ShubhaVijayaraj/EPICS-INDIA-Bullock-Driven-Tractor-Delivery/images/IMG_1473.png

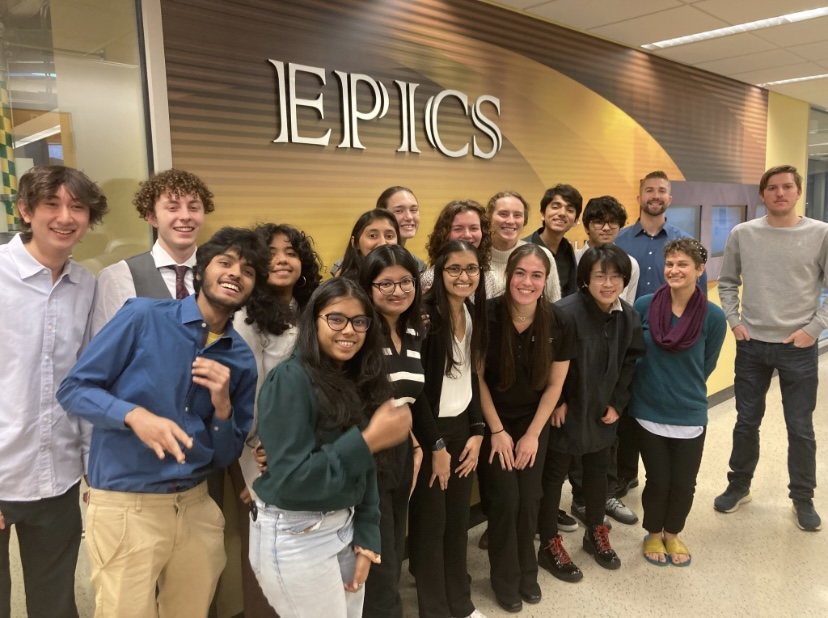
images/IMG_1473.png
