ShubhaVijayaraj/EPICS-INDIA-Bullock-Driven-Tractor-Delivery/Deliverables/Drawings/Frame/Watermarked Frame Drawings.pdf

# Frame Drawings

APPROVED
CHECKED 4/28/2025

SIZE
B

DRAWN Shubha Vijayaraj4/28/2025SCALE

CODE

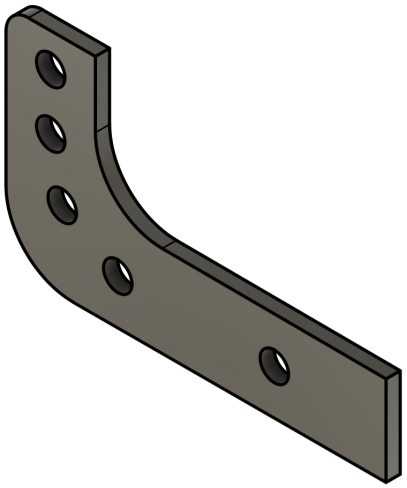
[picture p2: figure]

WEIGHT

DWG NO
1

SHEET

REV

85
60

R10

35

40

20

19.97

25.14

50

120

R30

170

90.33°

Ø12.7

20
40

100

1:2

6.35

1/1

PROJECT

# Bullock Driven Tractor

TITLE

# Hitching Attachment

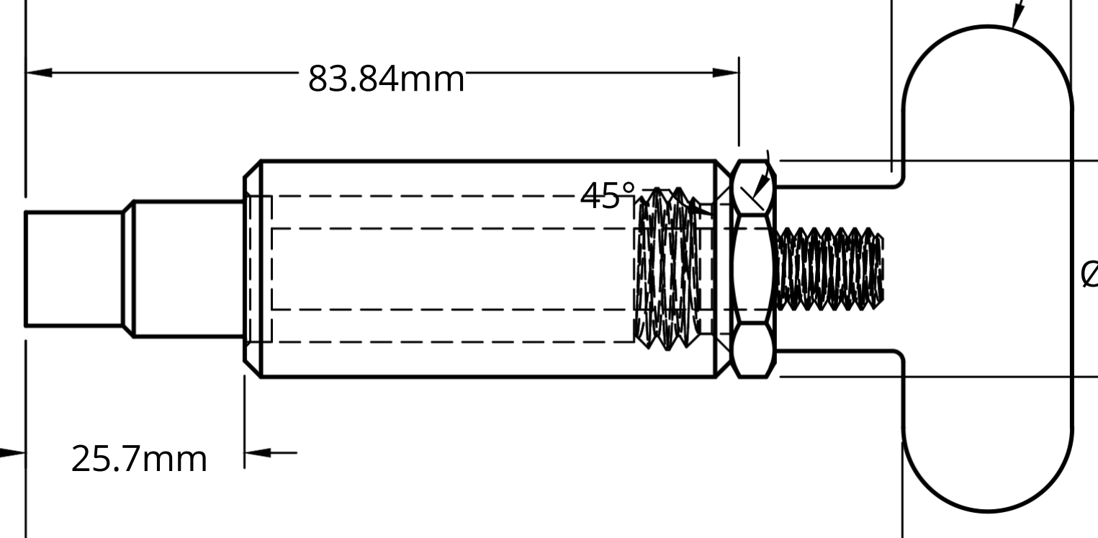
[picture p3: figure]

APPROVED
CHECKED

SIZE

CODE

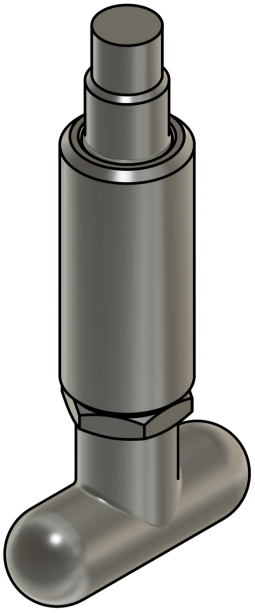
[picture p4: figure]

DWG NO

REV

112.95mm

Ø19.81mm

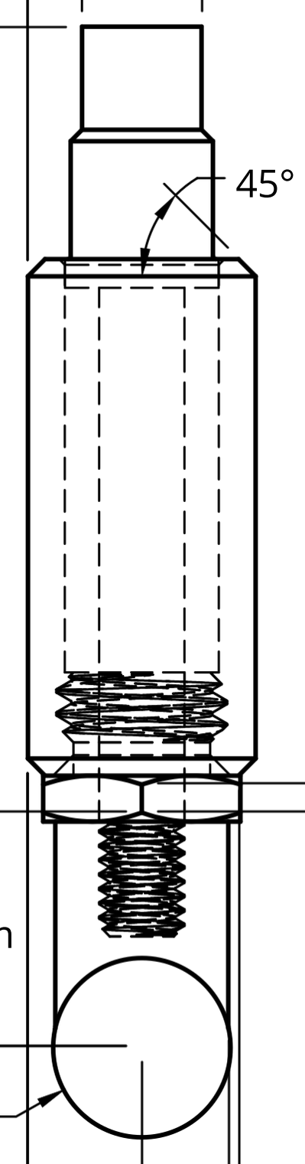
[picture p5: figure]

26mm

12.7mm

22.35mm

23.5mm

19.37mm

6.03mm

3.12mm

103.05mm

122.86mm

101.78mm
R9.91mm

Ø25.4mm

1:1 | 1/1

PROJECT

# BDT

TITLE

# 90222A802_Steel Weld-Mount Retrac

A

P

P

R

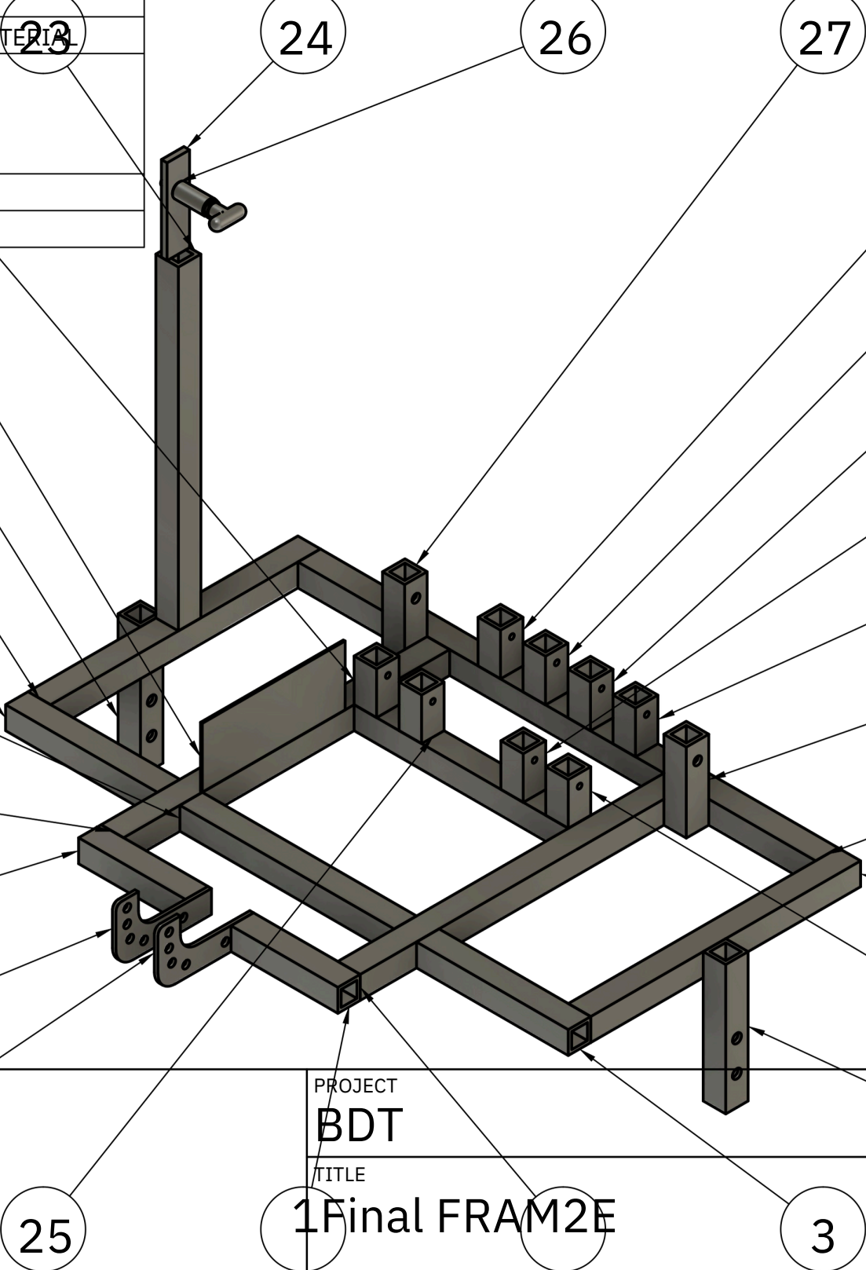
[picture p6: figure]

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
1234567891011121314151617181920212223

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
11111

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
21111
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
2728

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
3612111816

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
# Fin

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
0892854717

APPROVED
CHECKED

SIZE

CODE

DWG NO

REV

40mm

20mm

10mm

50.8mm

150.6mm

Ø15.88 10

1:1 | 1/1

PROJECT

# BDT

TITLE

# Locking Mechniam Vert Bar Arm

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
Dept. | Technical reference

Rev.

DWG No.

Approved by

Document status

Sheet

254mm

Created by
Shubha Vijayaraj4/28/2025

Document type

3.18mm

Date of issue
4/27/2025 1/1

Title

## Foot Protector

1

0

6.2

m

m
