ShubhaVijayaraj/EPICS-INDIA-Bullock-Driven-Tractor-Delivery/images/Screenshot 2025-06-06 010942.png

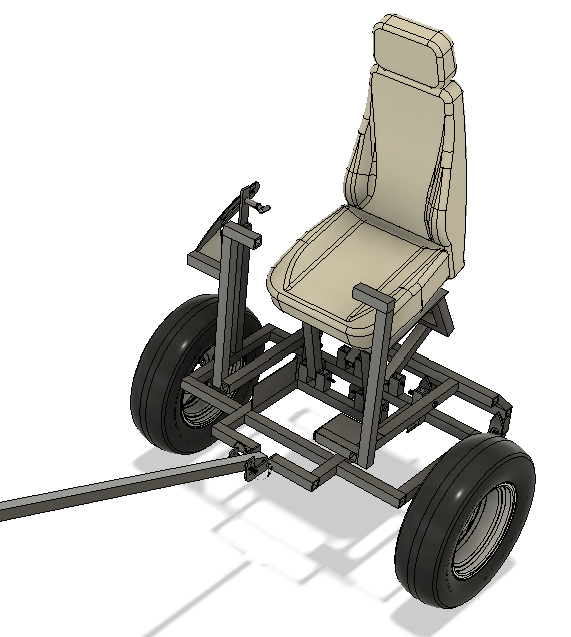
images/Screenshot 2025-06-06 010942.png
