ShubhaVijayaraj/EPICS-INDIA-Bullock-Driven-Tractor-Delivery/Deliverables/Manufacturing Document and B.O.M..xlsx

Sheet: Manufacturing Processes
Component | Subcomponent | Part Name | Part Visual | Process/Operation | Specification/Tolerance
Lifting Mechanism | Locking Mechanism | Arced Bar |  | Waterjet/ Laser cutter - Welded to horizontal connector to lifting mechanism - 4 mm gauge metal plate
 |  | Triangle support |  | Waterjet/Laser Cutter - Welded at horizontal connector bar and arced bar - 4 mm gauge metal plate
 |  | Arced Guides |  | Waterjet/ Laser cutter - Welded to arced Bar - 4 mm gauge metal plate | Guides are fit to holes with little clearance so spring plunger can be guided through arc
 | Plow Section | Plow Diagonal |  | Drill hole on bar and then use vertical Bandsaw to cut at angle and welded onto vertical bar | Hole is placed where threaded rod goes and can be a through hole. Drill at least 3 mm to create a base for the rod to be welded onto.
 |  | Plow Vertical |  | Horizontal Bandsaw to cut bar. Drill press to create hole
 |  | Welded Rod |  | Weld M10 (24 mm long) threaded rod normal to plow diagonal
 | LM Main Frame | Horizontal bars |  | Horizonal Bandsaw and Drill Press - welded to plow, foot pedal, and locking mechanism vertical
 |  | Plow Diagonal Bars |  | Horizontal Bandsaw to cut angles and welded joints
 |  | LM Foot Pedal |  | Sheet metal bending and welded onto foot rest of LM
Frame | Wheel Attachment | Wheel Attachment Bars |  | Drill Press into steel tubing sections first, drilling through all material. Once completed, weld onto frame at the specification of manufacturing manual, ensuring both sides are at the same height and flush.
 | Hitching Attachment | Hitching Attachment piece |  | Waterjet/Laser Cutter - Welded onto frame on 4mm gauge steel plate
 | Main Frame Components | Main Frame Components |  | Cut pieces following drawing lengths and drill holes at specified points. Then weld joints at specified points
 | Locking Mechanism |  |  | Begin by drilling hole into vertical bar, where the spring plunger will be inserted. Weld spring plunger casing to the face of vertical bar. Weld vertical bar onto vertical steel tubing, with casing being on the inner side of the tractor.
 | Locking Mechanism |  |  | Weld vertical tubing onto frame, ensuring that casing is pointed toward the interior of the tractor. The tubing will be welded onto the frame near the wheel attachment points. | Ensure casing is on interior, failure to do so will require removing the casing from its weld and rewelding it.
Seat |  | Seat Rest |  | 4 mm gauge steel plate welded to seat legs
 |  | Chains |  | Chains cut to length - 0.534 m
Spring Plunger |  | Extending Spring Plunger Length |  | If the appropriate length for spring plunger cannot be found then implement the modification here. Drill a 13.2mm hole into the top of the spring plunger extension. Tap with a

Sheet: B.O.M. - U.S. Sources
Assembly | Part No. | Material | Total Quantity | Units
Lifting Mechanism | A1 | Square Tubing | 5.363 | m
 | A2 | Sheet Metal | 0.083 | m^2
Frame | B1 | Square Tubing | 6.1626 | m
 | B2 | Sheet Metal | 0.085 | m^2
 | B3 | Wheels | 2 | ~
 | B4 | Spring Plunger | 1 | ~
Hitching Medium | C1 | Square Tubing | 2.4 | m
Pressure Bars | D1 | Square Tubing | 0.74 | m
Seat | E1 | Square Tubing | 1.419 | m
 | E2 | Sheet Metal | 0.165 | m^2
 | E3 | Seat | 1 | ~
Plow Spikes | F1 | Square Tubing | 0.58 | m
 | F2 | Plow Spikes | 4 | ~
Bolts, Screws | G1 | M16 x 150mm | 2 | ~
 | G2 | M10 x 150mm | 2 | ~
 | G3 | M10 x 30cm | 1 | ~
 | G4 | M14 x 110mm | 2 | ~
 | G5 | M12 x 75mm | 4 | ~
 | G6 | M14 x 120mm | 1 | ~
 | G7 | M14 x 140mm | 1 | ~
 | G8 | M12 x 25mm | 4 | ~
Nuts, Spacers, Washers | H1 | M10 x 1.25mm | 4 | ~
 | H2 | M12 x 1.25mm | 4 | ~
 | H3 | M16 x 1.5mm | 4 | ~
 | H4 | M12 Steel Washer | 2 | ~
 | H5 | M16 Steel Washer | 2 | ~
 | H6 | Vibration-Damping Unthreaded Spacer | 2 | ~
Material | Total Quantity | Units | Source | Link/Catalog | Unit Cost ($) | Line Total Cost
Square Tubing | 16.66 | m | Online Metals | Online Metals, 288in (https://www.onlinemetals.com/en/buy/carbon-steel/1-5-x-0-12-carbon-steel-square-tube-a500-a513-hot-rolled/pid/10326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) | 109.56 | 249.59
Sheet Metal | 0.33 | m^2 | Online Metals | Online Metals, 48"x144" (https://www.onlinemetals.com/en/buy/carbon-steel/0-1875-carbon-steel-plate-a1011-hot-rolled/pid/9993) | 456.52 | 35.61
Seat | 1 | ea | Recycle | ~ | ~ | 0.00
Plow Spikes | 4 | ea | Farmer Bob | Farmer Bob (https://farmerbobsparts.com/spring-tooth-reversible-cultivator-point-3-wide-x-5-16-thick-x-10-5-long/) | 21.95 | 87.80
Wheels | 2 | ea | Amazon | Amazon Wheelbarrow Tire (https://www.amazon.com/dp/B0DBLF9RLL?sp_csd=d2lkZ2V0TmFtZT1zcF9ocXBfc2hhcmVk) | 32.99 | 65.98
Spring Plunger | 1 | ea | McMaster-Carr | McMaster-Carr (https://www.mcmaster.com/products/spring-plungers/spring-plunger-nose-type~long/t-handle-weld-on-retractable-spring-plungers~~/) | 7.08 | 7.08
M16 x 150mm | 2 | ea | Bolt Depot | Bolt Depot, bulk of 250 (https://boltdepot.com/Product-Details?product=15011) | 918.00 | 7.34
M10 x 150mm | 2 | ea | Bolt Depot | Bolt Depot, bulk of 500 (https://boltdepot.com/Product-Details?product=6256) | 806.00 | 3.22
M10 x 300mm | 1 | ea | Bolt Depot | Bolt Depot, pack of 20 (https://boltdepot.com/Product-Details?product=23784) | 286.07 | 4.77
M14 x 110mm | 2 | ea | Bolt Depot | Bolt Depot, bulk of 250 (https://boltdepot.com/BrowseList?Units=Metric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) | 582.00 | 4.66
M12 x 75mm | 4 | ea | Bolt Depot | Bolt Depot, bulk of 500 (https://boltdepot.com/Product-Details?product=6266) | 445.00 | 3.56
M14 x 120mm | 1 | ea | Bolt Depot | Bolt Depot, bulk of 250 (https://boltdepot.com/Product-Details?product=6287) | 661.00 | 2.64
M14 x 140mm, Clevis | 1 | ea | Bolt Depot | Clevis Pin, 1 each (https://www.mcmaster.com/98412A508/) | 14.14 | 14.14
M12 x 25mm Rods | 4 | ea | Bolt Depot | Bolt Depot, 1 m rod (https://boltdepot.com/Product-Details?product=23785) | 26.41 | 2.64
M10 x 1.25mm Nut | 4 | ea | Bolt Depot | Bolt Depot, bulk of 1000 (https://boltdepot.com/Product-Details?product=4789) | 93.80 | 0.38
M12 x 1.25mm Nut | 4 | ea | Bolt Depot | Bolt Depot, bulk of 500 (https://boltdepot.com/Product-Details?product=4780) | 146.00 | 1.17
M16 x 1.5mm Nut | 4 | ea | Bolt Depot | Bolt Depot, bulk of 500 (https://boltdepot.com/Product-Details?product=7360) | 123.00 | 0.98
M12 Steel Washer | 2 | ea | Bolt Depot | Bolt Depot, bulk of 500 (https://boltdepot.com/Product-Details?product=4520) | 67.70 | 0.27
M16 Steel Washer | 2 | ea | Bolt Depot | Bolt Depot, bulk of 1000 (https://boltdepot.com/Product-Details?product=4533) | 141.00 | 0.28
 |  |  |  |  | Total Cost: | $492.11

Sheet: Steel Breakdown
Assembly | Material | Units | Part | Total Quantity
Frame | Square Tubing | m | Wheel Attachments (x2) | 0.46
 |  |  | Front Left and Right (x2) | 0.54
 |  |  | Left and Right (x2) | 0.88
 |  |  | Front | 0.381
 |  |  | Middle Left and Right (x2) | 1.16
 |  |  | Hitching Front Left and Right (x2) | 0.38
 |  |  | Back | 0.921
 |  |  | Vertical Bar | 0.5606
 |  |  | Short Verticals Parallel to Frame (x2) | 0.28
 |  |  | Short Verticals Flush to Frame (x8) | 0.6
 | Sheet Metal | m^2 | Foot Protector | 0.067
 |  |  | Hitching Attachment (x2) | 0.018
Lifting Mechanism | Square Tubing | m | Verticals (x2) | 1.292
 |  |  | Handles (x2) | 0.24
 |  |  | Sides (x2) | 1.22
 |  |  | Both Back Bars (x2) | 1.8288
 |  |  | Angled Back Bars (x2) | 0.3302
 |  |  | Plow Attachments (x4) | 0.3
 |  |  | Locking Offset | 0.152
 | Sheet Metal | m^2 | Foot Protector | 0.051
 |  |  | Arc Bar | 0.017
 |  |  | Stopper | 0.009
 |  |  | Arc Bar Guide (x2) | 0.006
Hitching Medium | Square Tubing | m | Hitching Medium | 2.4
Pressure Bars | Square Tubing | m | Pressure Bars (x2) | 0.74
Seat | Square Tubing | m | Front Legs (x2) | 0.61
 |  |  | Back Legs (x2) | 0.504
 |  |  | Connecting Back Leg | 0.305
 | Sheet Metal | m^2 | Base | 0.165
Plow Spikes | Square Tubing | m | Straight (x4) | 0.368
 |  |  | Diagonal (x4) | 0.212
 |  | Assembly | Totals for Square Tubing [m] | Totals for Sheets [m^2]
 |  | Frame | 6.1626 | 0.085
 |  | Lifting Mechanism | 5.363 | 0.083
 |  | Hitching Medium | 2.4 | 0
 |  | Pressure Bars | 0.74 | 0
 |  | Seat | 1.419 | 0.165
 |  | Plow Spikes | 0.58 | 0
 |  | Totals: | 16.6646 | 0.333
