ShubhaVijayaraj/EPICS-INDIA-Bullock-Driven-Tractor-Delivery/Deliverables/CAD Files/Lifting and Locking Mechanism/Plow Attachment Assembly v12.step

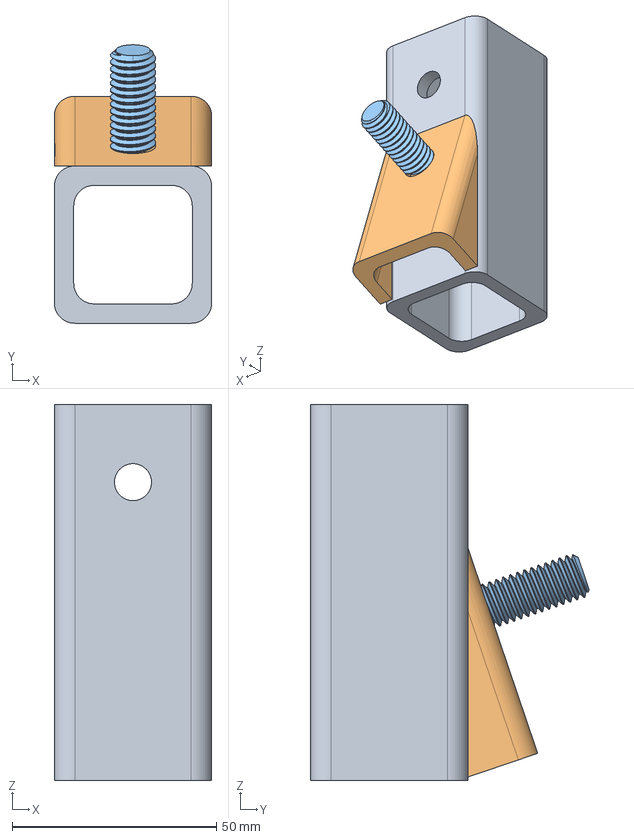
[picture p8: CAD file, 2025-06-29]
Deliverables/CAD Files/Lifting and Locking Mechanism/Plow Attachment Assembly v12.step
38.5 x 68.2 x 92.0 mm
Plow Attachment Tube v1
Plow Attachment Slope
Plow Slope Threaded Rod
