ShubhaVijayaraj/EPICS-INDIA-Bullock-Driven-Tractor-Delivery/Deliverables/CAD Files/PlowAssemblyFinal v3.step

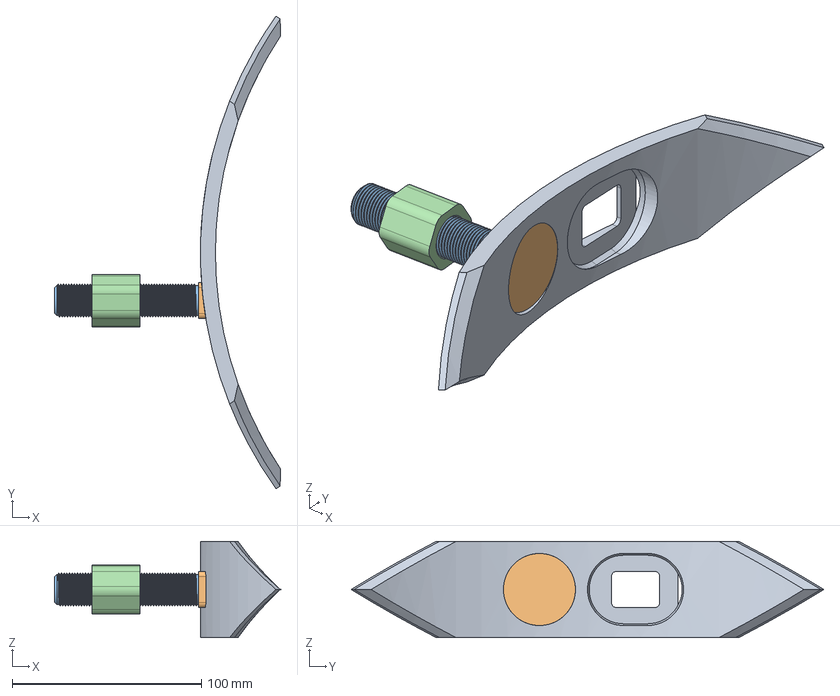
[picture p9: CAD file, 2025-06-29]
Deliverables/CAD Files/PlowAssemblyFinal v3.step
119.5 x 250.0 x 50.8 mm
17inchspike
EllipticalBolt
EllipticalNut
