ShubhaVijayaraj/EPICS-INDIA-Bullock-Driven-Tractor-Delivery/Deliverables/CAD Files/Frame/Frame Base/580 x 40 mm v3.step

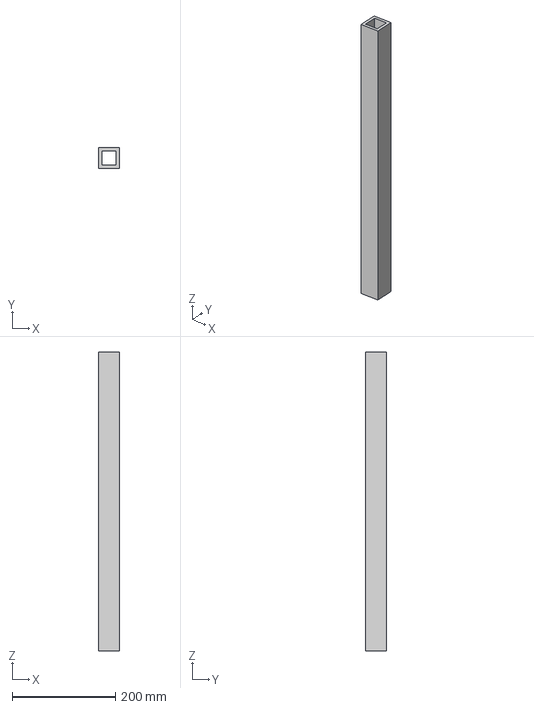
[picture p10: CAD file, 2025-06-29]
Deliverables/CAD Files/Frame/Frame Base/580 x 40 mm v3.step
40.0 x 40.0 x 580.0 mm
