ShubhaVijayaraj/EPICS-INDIA-Bullock-Driven-Tractor-Delivery/Deliverables/CAD Files/Lifting and Locking Mechanism/Lifting Mechanism Base/75mm x 40mm v2.step

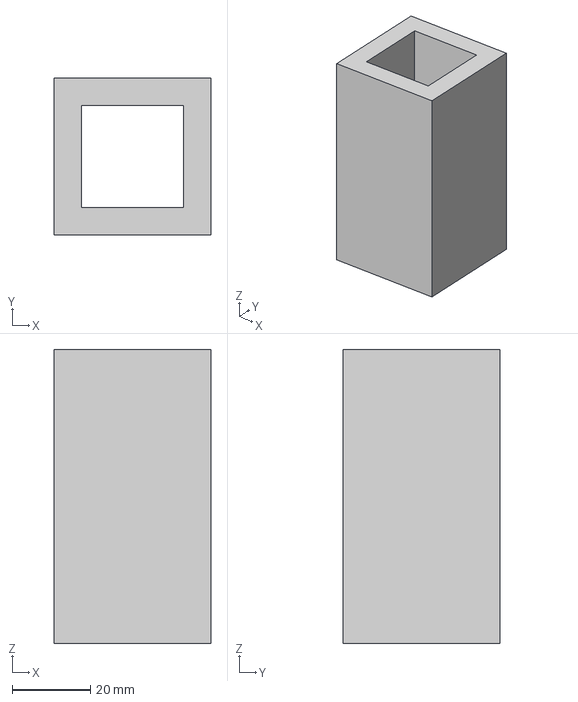
[picture p11: CAD file, 2025-06-29]
Deliverables/CAD Files/Lifting and Locking Mechanism/Lifting Mechanism Base/75mm x 40mm v2.step
40.0 x 40.0 x 75.0 mm
