ShubhaVijayaraj/EPICS-INDIA-Bullock-Driven-Tractor-Delivery/Deliverables/CAD Files/Lifting and Locking Mechanism/Lifting Mechanism v37.step

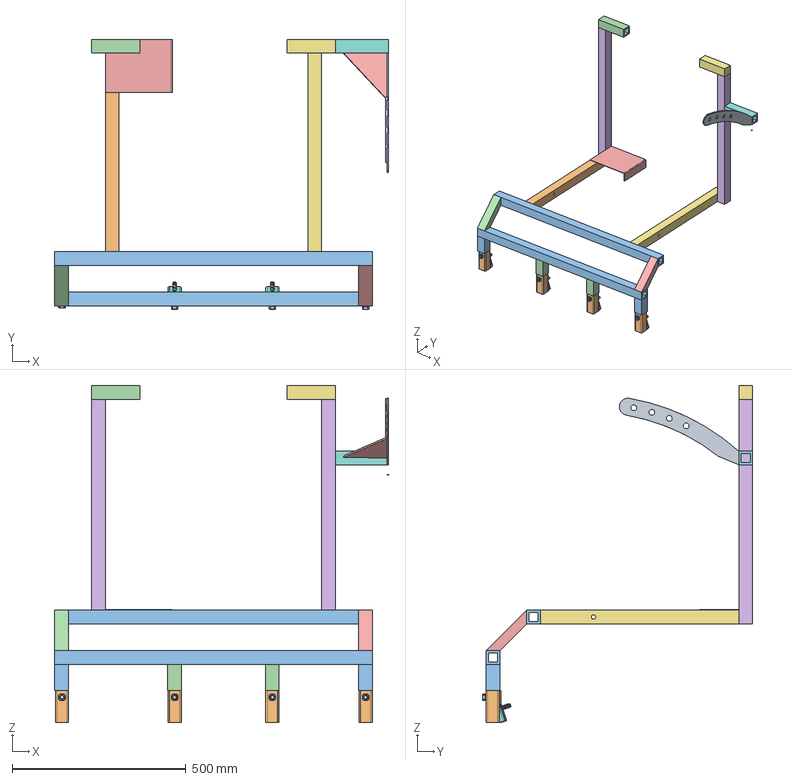
[picture p12: CAD file, 2025-06-29]
Deliverables/CAD Files/Lifting and Locking Mechanism/Lifting Mechanism v37.step
960.4 x 777.6 x 969.7 mm
Locking Mechanism Arc Bar
75mm x 40mm x 2
PlowAttachmentPoint x 2
Foot Protector Final Design
Locking mechanism update
Plow Attachment Slope_4 x 4
Plow Attachment Tube x 4
93975A119_Square Weld Nuts x 4
Plow Slope Threaded Rod x 4
