ShubhaVijayaraj/EPICS-INDIA-Bullock-Driven-Tractor-Delivery/Deliverables/CAD Files/Seat/Pressure Bars v1.step

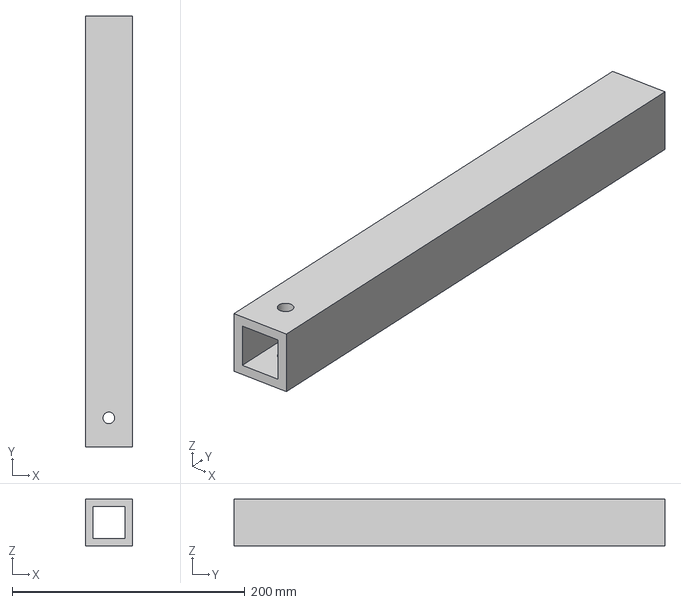
[picture p13: CAD file, 2025-06-29]
Deliverables/CAD Files/Seat/Pressure Bars v1.step
40.0 x 370.0 x 40.0 mm
