ShubhaVijayaraj/EPICS-INDIA-Bullock-Driven-Tractor-Delivery/Deliverables/CAD Files/Frame/Frame Base/190 x 40 mm v2.step

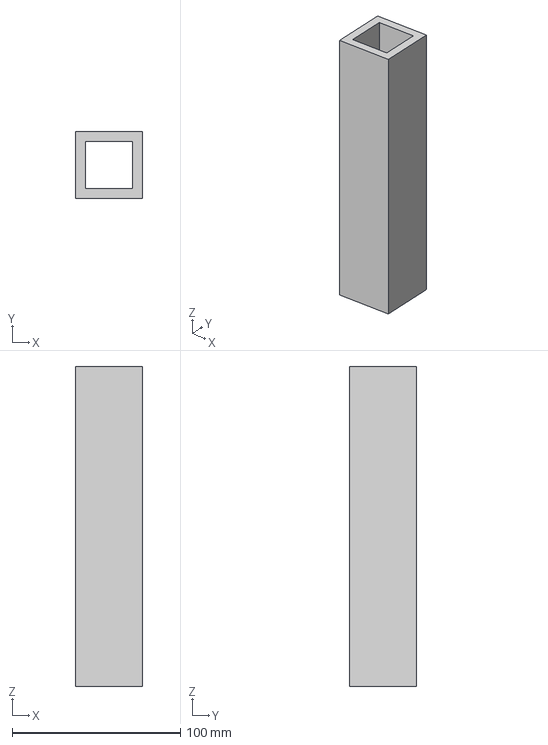
[picture p14: CAD file, 2025-06-29]
Deliverables/CAD Files/Frame/Frame Base/190 x 40 mm v2.step
40.0 x 40.0 x 190.0 mm
