ShubhaVijayaraj/EPICS-INDIA-Bullock-Driven-Tractor-Delivery/Deliverables/CAD Files/Frame/Hitching Attachment v1.step

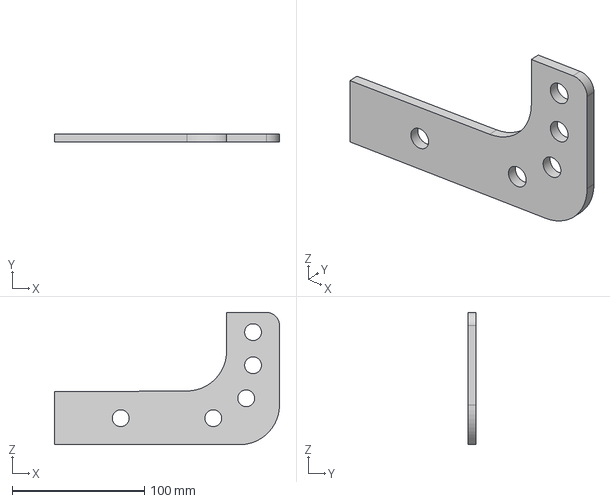
[picture p15: CAD file, 2025-06-29]
Deliverables/CAD Files/Frame/Hitching Attachment v1.step
170.0 x 6.35 x 100.0 mm
