ShubhaVijayaraj/EPICS-INDIA-Bullock-Driven-Tractor-Delivery/Deliverables/CAD Files/hitching bar v3.step

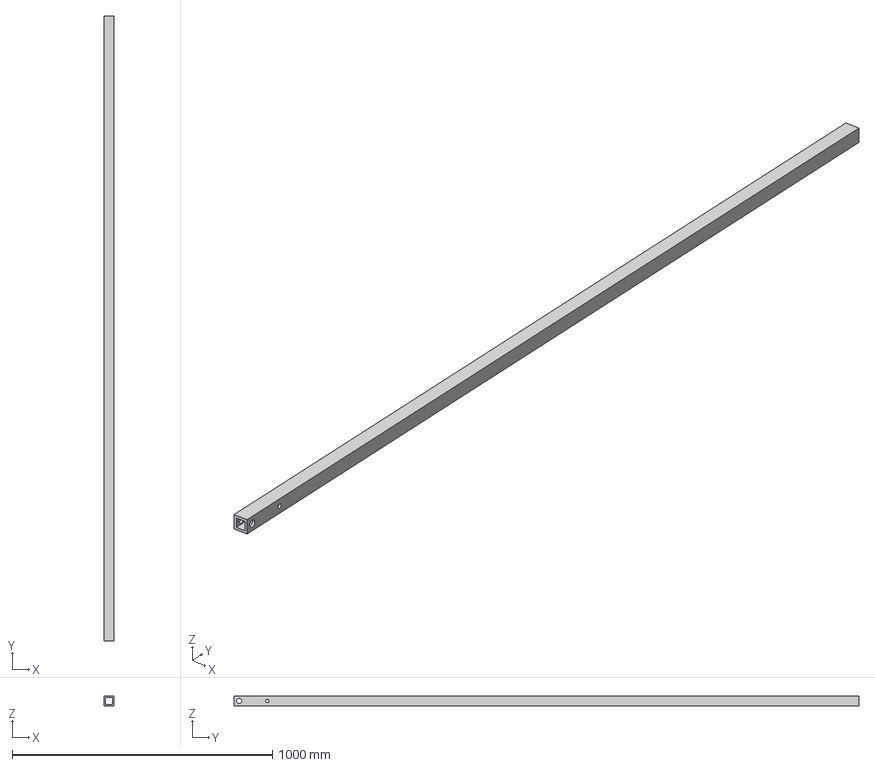
[picture p16: CAD file, 2025-06-29]
Deliverables/CAD Files/hitching bar v3.step
40.0 x 2400.0 x 40.0 mm
