ShubhaVijayaraj/EPICS-INDIA-Bullock-Driven-Tractor-Delivery/Deliverables/CAD Files/Seat/new_seat v10.step

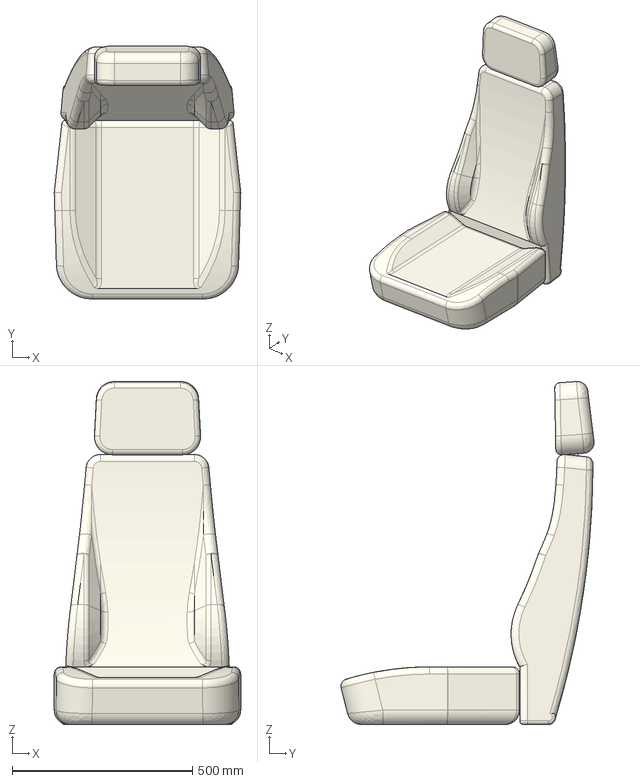
[picture p17: CAD file, 2025-06-29]
Deliverables/CAD Files/Seat/new_seat v10.step
518.0 x 702.8 x 952.4 mm
