ShubhaVijayaraj/EPICS-INDIA-Bullock-Driven-Tractor-Delivery/Deliverables/CAD Files/Frame/Foot Protector v2.step

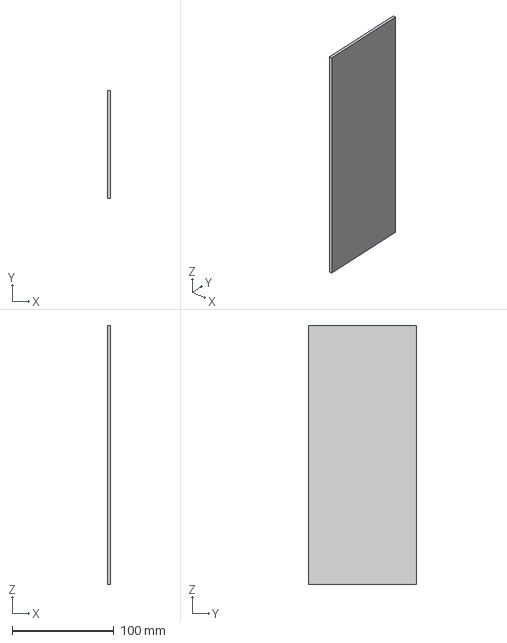
[picture p18: CAD file, 2025-06-29]
Deliverables/CAD Files/Frame/Foot Protector v2.step
3.17 x 106.2 x 254.0 mm
