ShubhaVijayaraj/EPICS-INDIA-Bullock-Driven-Tractor-Delivery/Deliverables/CAD Files/Frame/Frame Base/Locking Mechanism Vert Bar Base v3.step

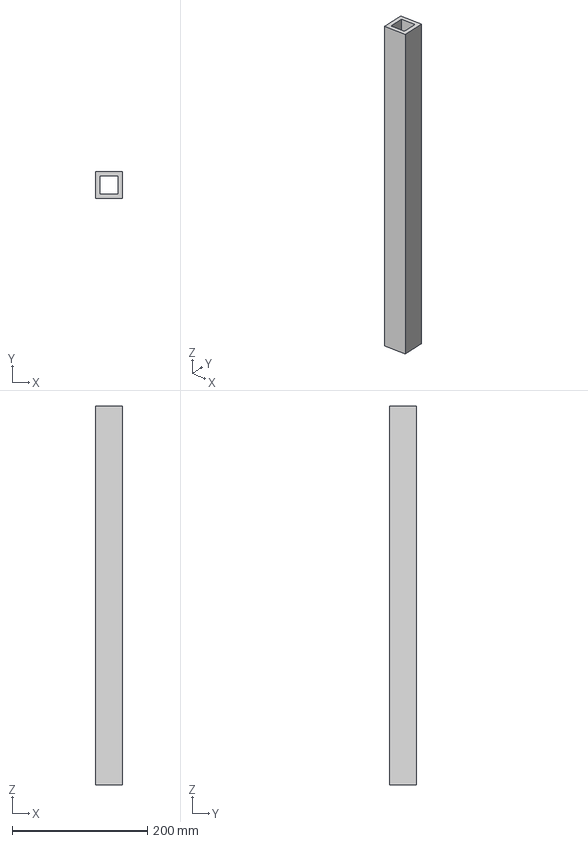
[picture p19: CAD file, 2025-06-29]
Deliverables/CAD Files/Frame/Frame Base/Locking Mechanism Vert Bar Base v3.step
40.0 x 40.0 x 560.6 mm
