ShubhaVijayaraj/EPICS-INDIA-Bullock-Driven-Tractor-Delivery/Deliverables/CAD Files/Lifting and Locking Mechanism/Locking Mechanism Arc Bar v9.step

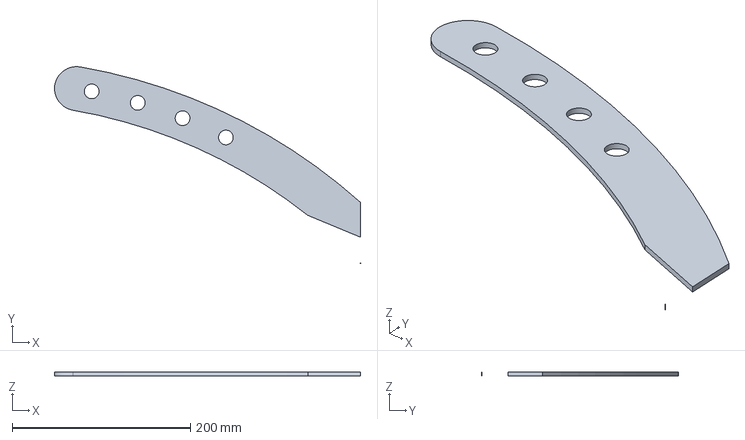
[picture p20: CAD file, 2025-06-29]
Deliverables/CAD Files/Lifting and Locking Mechanism/Locking Mechanism Arc Bar v9.step
343.6 x 220.8 x 4.00 mm
