ShubhaVijayaraj/EPICS-INDIA-Bullock-Driven-Tractor-Delivery/Deliverables/CAD Files/Seat/Chair Stand v7.step

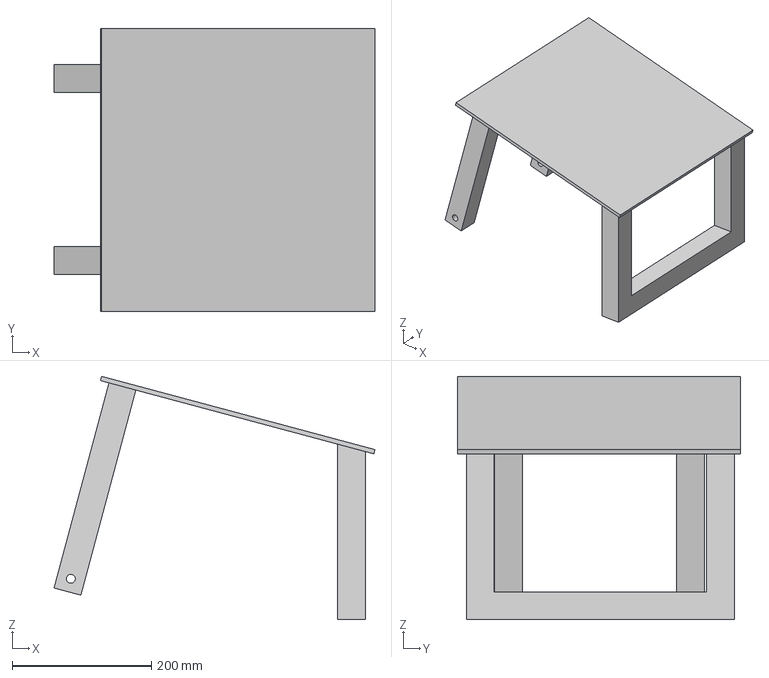
[picture p21: CAD file, 2025-06-29]
Deliverables/CAD Files/Seat/Chair Stand v7.step
460.8 x 406.4 x 349.3 mm
