ShubhaVijayaraj/EPICS-INDIA-Bullock-Driven-Tractor-Delivery/Deliverables/CAD Files/14inch Wheel Rim and Tyre v1.step

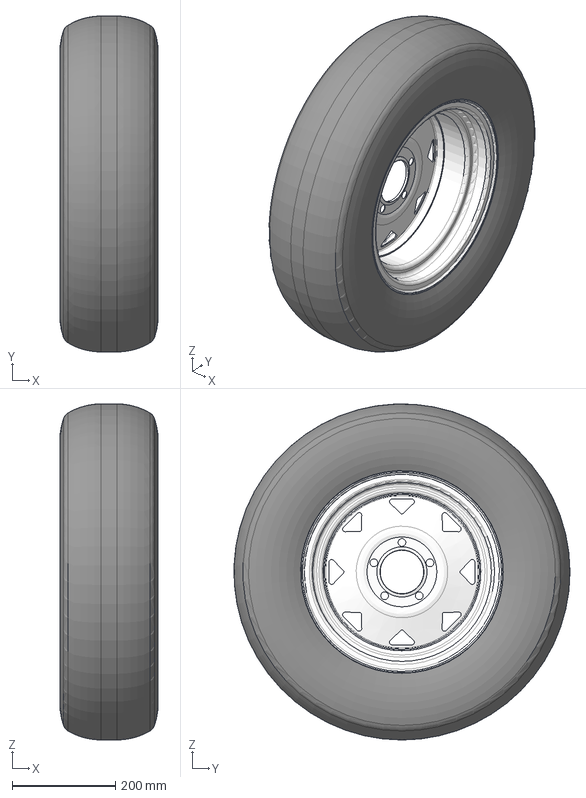
[picture p22: CAD file, 2025-06-29]
Deliverables/CAD Files/14inch Wheel Rim and Tyre v1.step
189.9 x 649.8 x 649.8 mm
