ShubhaVijayaraj/EPICS-INDIA-Bullock-Driven-Tractor-Delivery/Deliverables/CAD Files/Frame/Final FRAME v19.step

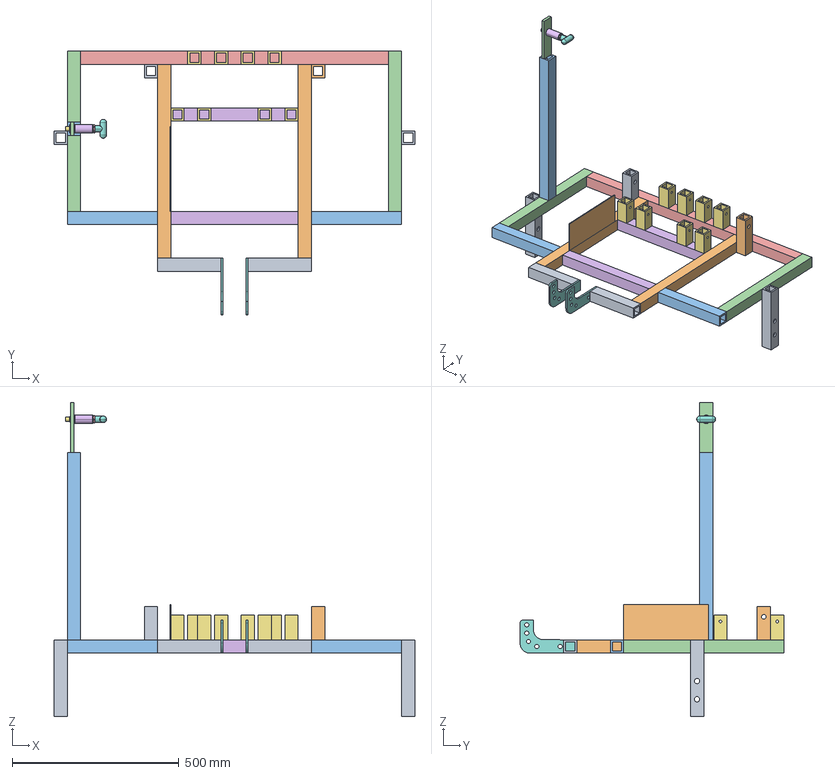
[picture p23: CAD file, 2025-06-29]
Deliverables/CAD Files/Frame/Final FRAME v19.step
1081.0 x 790.0 x 941.2 mm
921.00 mm x 40.00 mm
Component1(Mirror) (2)
Component1(Mirror)
Component1(Mirror) (3)
Component1(Mirror) (1)
Component1(Mirror) (7)
Hitching Attachment
hithcing rig v1(Mirror)
Component1(Mirror) (8)
Foot Protector
Component1(Mirror) (9)
Component1(Mirror) (10)
Locking Mechanism Vert Bar Base
Locking Mechniam Vert Bar Arm
90222A802_Steel Weld-Mount Retractable Spring Plunger
