ShubhaVijayaraj/EPICS-INDIA-Bullock-Driven-Tractor-Delivery/Deliverables/CAD Files/Lifting and Locking Mechanism/Foot Protector Final Design v3.step

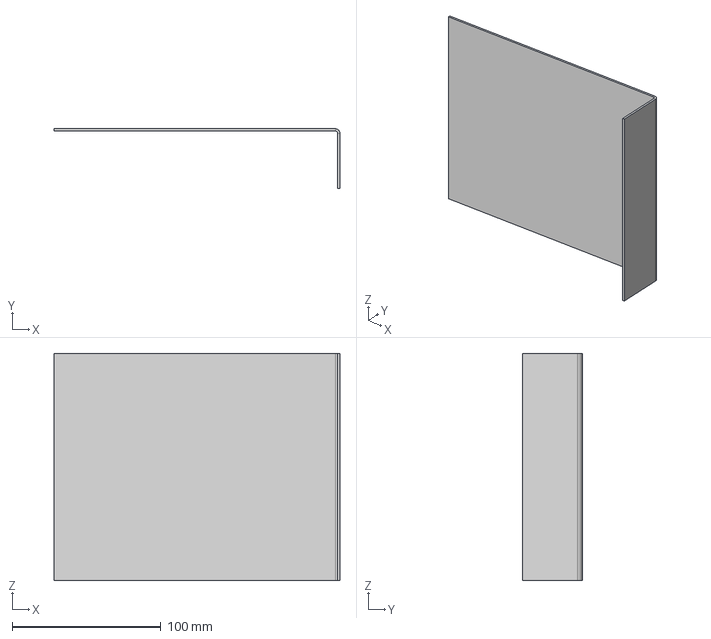
[picture p25: CAD file, 2025-06-29]
Deliverables/CAD Files/Lifting and Locking Mechanism/Foot Protector Final Design v3.step
192.0 x 40.0 x 152.4 mm
