ShubhaVijayaraj/EPICS-INDIA-Bullock-Driven-Tractor-Delivery/Deliverables/CAD Files/Frame/Frame Base/480 x 40 mm v2.step

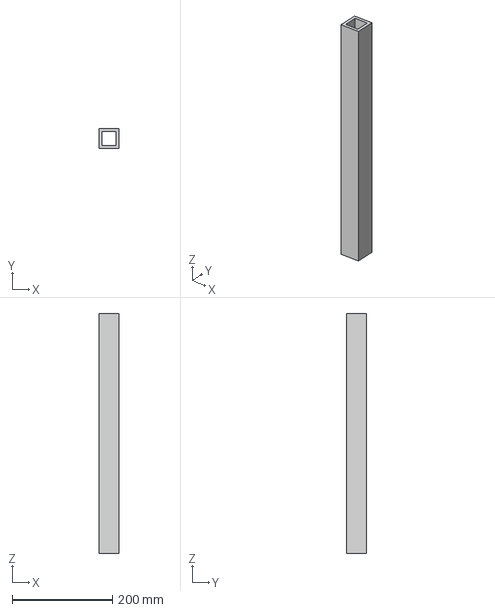
[picture p26: CAD file, 2025-06-29]
Deliverables/CAD Files/Frame/Frame Base/480 x 40 mm v2.step
40.0 x 40.0 x 480.0 mm
