ShubhaVijayaraj/EPICS-INDIA-Bullock-Driven-Tractor-Delivery/Deliverables/CAD Files/Lifting and Locking Mechanism/Locking mechanism update v12.step

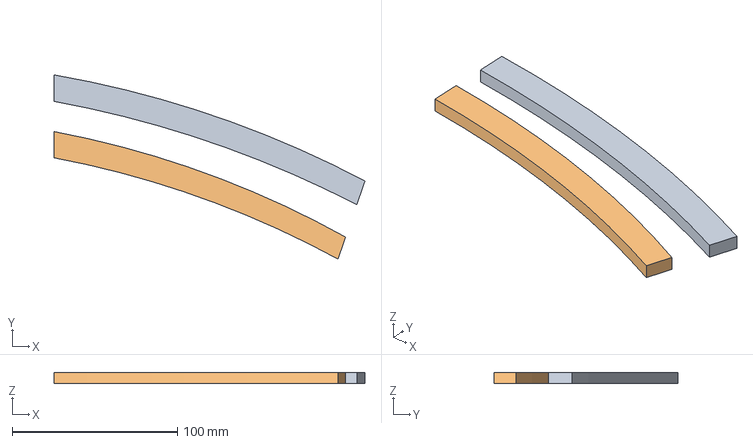
[picture p27: CAD file, 2025-06-29]
Deliverables/CAD Files/Lifting and Locking Mechanism/Locking mechanism update v12.step
188.0 x 111.3 x 6.35 mm
