ShubhaVijayaraj/EPICS-INDIA-Bullock-Driven-Tractor-Delivery/Deliverables/CAD Files/Frame/Frame Base/230 x 40 mm v6.step

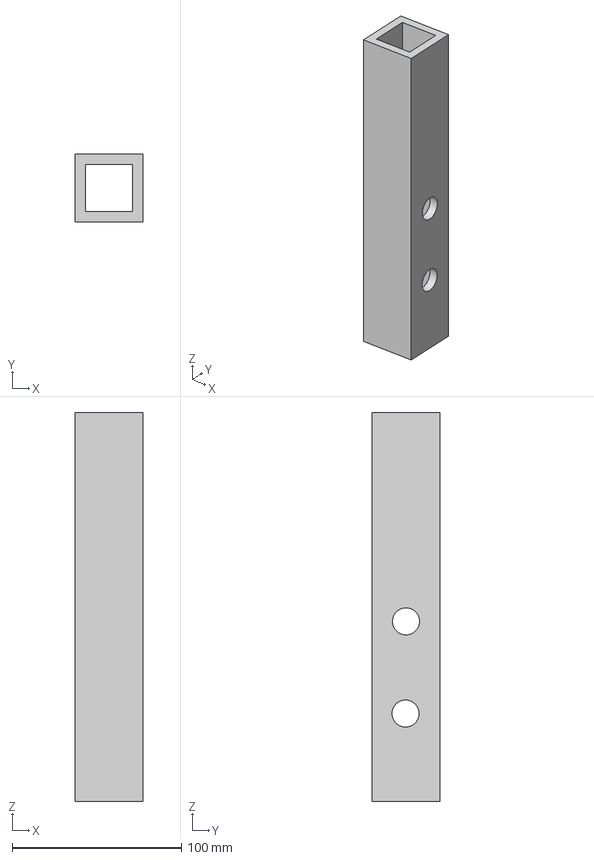
[picture p28: CAD file, 2025-06-29]
Deliverables/CAD Files/Frame/Frame Base/230 x 40 mm v6.step
40.0 x 40.0 x 230.0 mm
