ShubhaVijayaraj/EPICS-INDIA-Bullock-Driven-Tractor-Delivery/Deliverables/CAD Files/Frame/Frame Base/921.00 mm x 40.00 mm v3.step

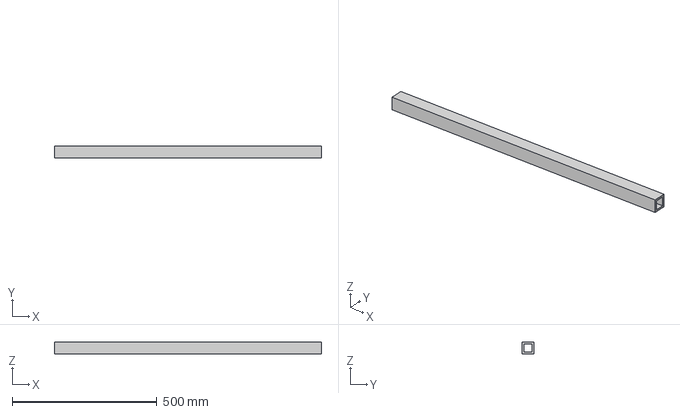
[picture p29: CAD file, 2025-06-29]
Deliverables/CAD Files/Frame/Frame Base/921.00 mm x 40.00 mm v3.step
921.0 x 40.0 x 40.0 mm
