ShubhaVijayaraj/EPICS-INDIA-Bullock-Driven-Tractor-Delivery/Deliverables/CAD Files/Frame/Frame Base/Locking Mechniam Vert Bar Arm v6.step

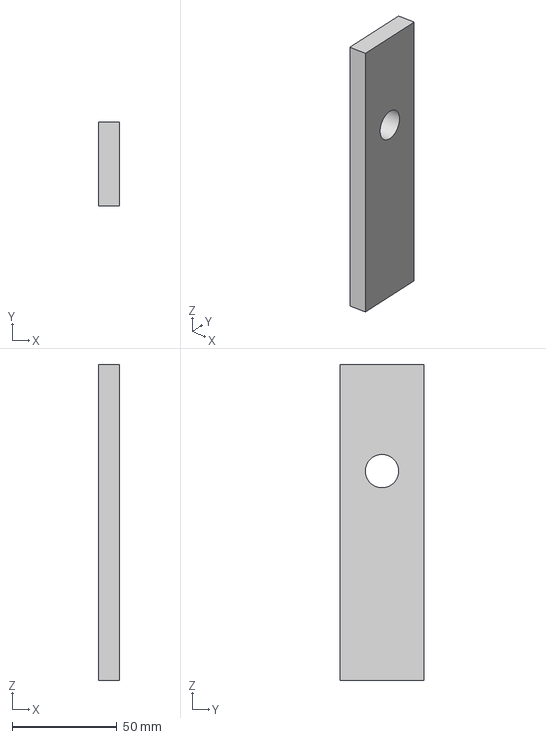
[picture p30: CAD file, 2025-06-29]
Deliverables/CAD Files/Frame/Frame Base/Locking Mechniam Vert Bar Arm v6.step
10.0 x 40.0 x 150.6 mm
