ShubhaVijayaraj/EPICS-INDIA-Bullock-Driven-Tractor-Delivery/Deliverables/CAD Files/Frame/Frame Base/270 x 40 mm v2.step

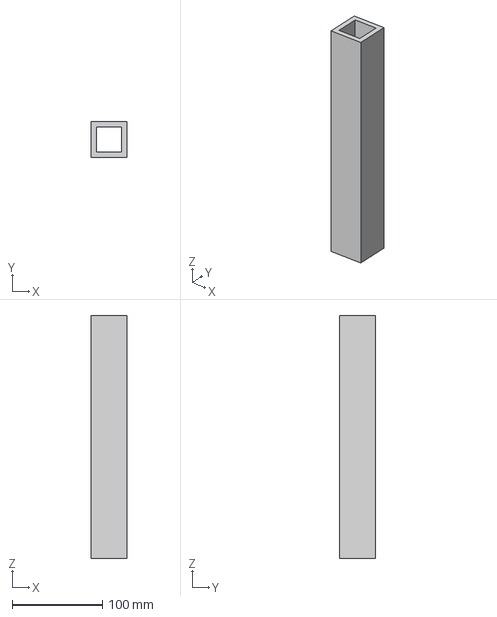
[picture p31: CAD file, 2025-06-29]
Deliverables/CAD Files/Frame/Frame Base/270 x 40 mm v2.step
40.0 x 40.0 x 270.0 mm
