ShubhaVijayaraj/EPICS-INDIA-Bullock-Driven-Tractor-Delivery/(list of files, cad)

Other CAD files:
Deliverables/CAD Files/Lifting and Locking Mechanism/Lifting Mechanism Base/PlowAttachmentPoint v2.step
Deliverables/CAD Files/Frame/90222A802_Steel Weld-Mount Retractable Spring Plunger v2.step
Deliverables/CAD Files/Nuts and Bolts/Hitching Bar Bolt v1.step
Deliverables/CAD Files/Nuts and Bolts/Hitching Bar Clevis Pin v1.step
Deliverables/CAD Files/Nuts and Bolts/Seat Bolts v1.step
Deliverables/CAD Files/Wheel Bolt v1.step
