ShubhaVijayaraj/EPICS-INDIA-Bullock-Driven-Tractor-Delivery/Deliverables/Drawings/Spring 2025 Final Assembly Drawing v1.pdf

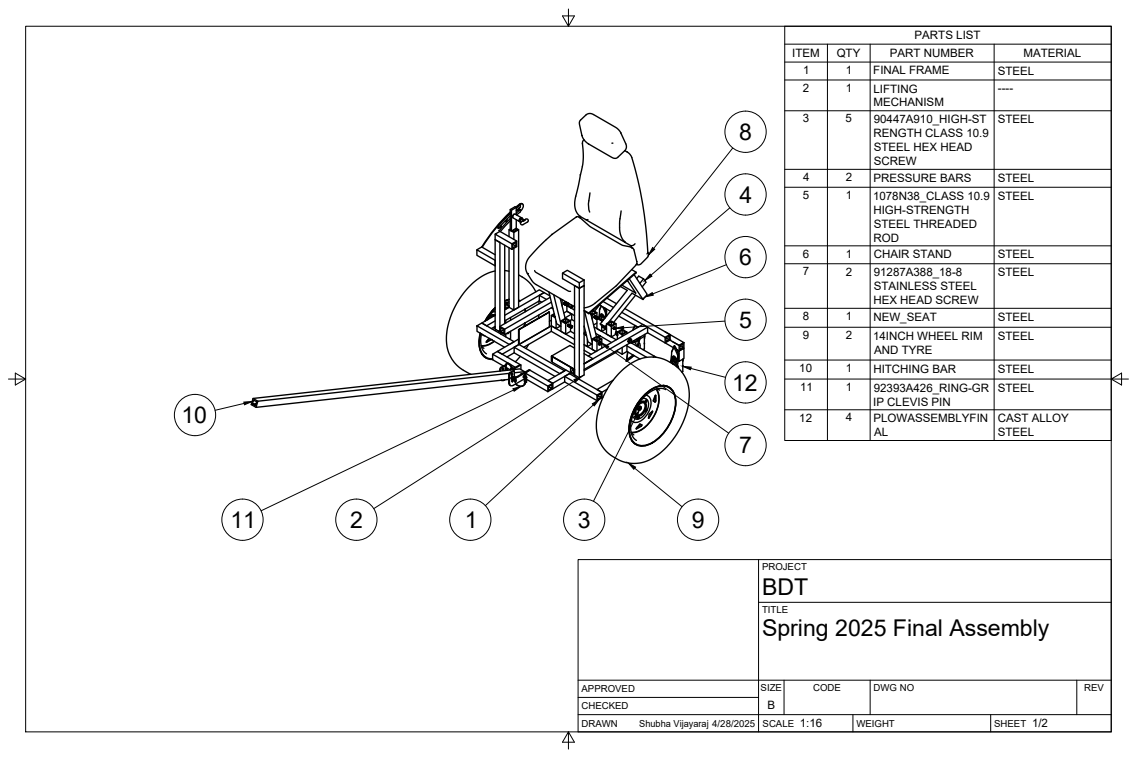
[picture p32: page 1]
SIZE; CODE; DWG NO; REV; Shubha Vijayaraj 4/28/2025; PARTS LIST

ITEM | QTY | PART NUMBER | MATERIAL
1 | 1 | FINAL FRAME | STEEL
2 | 5 1 | LIFTING 90447A910_HIGH-ST MECHANISM | ---- 3

RENGTH CLASS 10.9 STEEL HEX HEAD SCREW | STEEL

4 | 2 | PRESSURE BARS | STEEL
5 | 1 | 1078N38_CLASS 10.9 HIGH-STRENGTH STEEL THREADED ROD | STEEL

6 | 1 | CHAIR STAND | STEEL
7 | 2 | 91287A388_18-8 STAINLESS STEEL HEX HEAD SCREW | STEEL

8 | 1 | NEW_SEAT | STEEL
9 | 2 | 14INCH WHEEL RIM AND TYRE | STEEL

10 | 1 | HITCHING BAR | STEEL
11 | 1 | 92393A426_RING-GR IP CLEVIS PIN | STEEL

12 | 4 | PLOWASSEMBLYFIN AL | CAST ALLOY STEEL

PROJECT
BDT
Spring 2025 Final Assembly

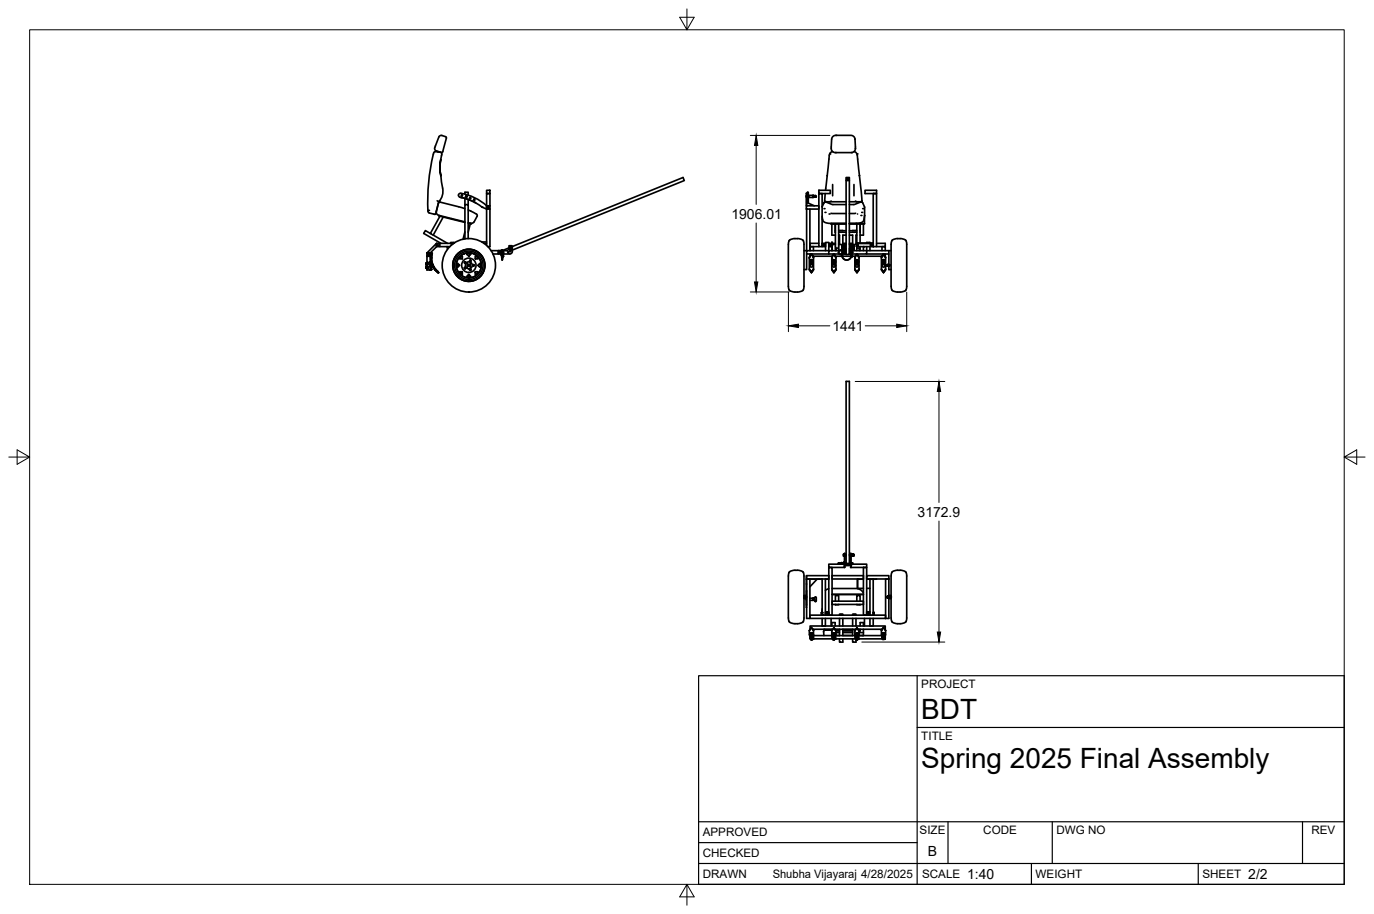
[picture p33: page 2]
SIZE; CODE; DWG NO; REV; Shubha Vijayaraj 4/28/2025

PROJECT
BDT
Spring 2025 Final Assembly
