ShubhaVijayaraj/EPICS-INDIA-Bullock-Driven-Tractor-Delivery/Deliverables/Drawings/Lifting and Locking Mechanism/Plow Attachment Assembly Drawing v1.pdf

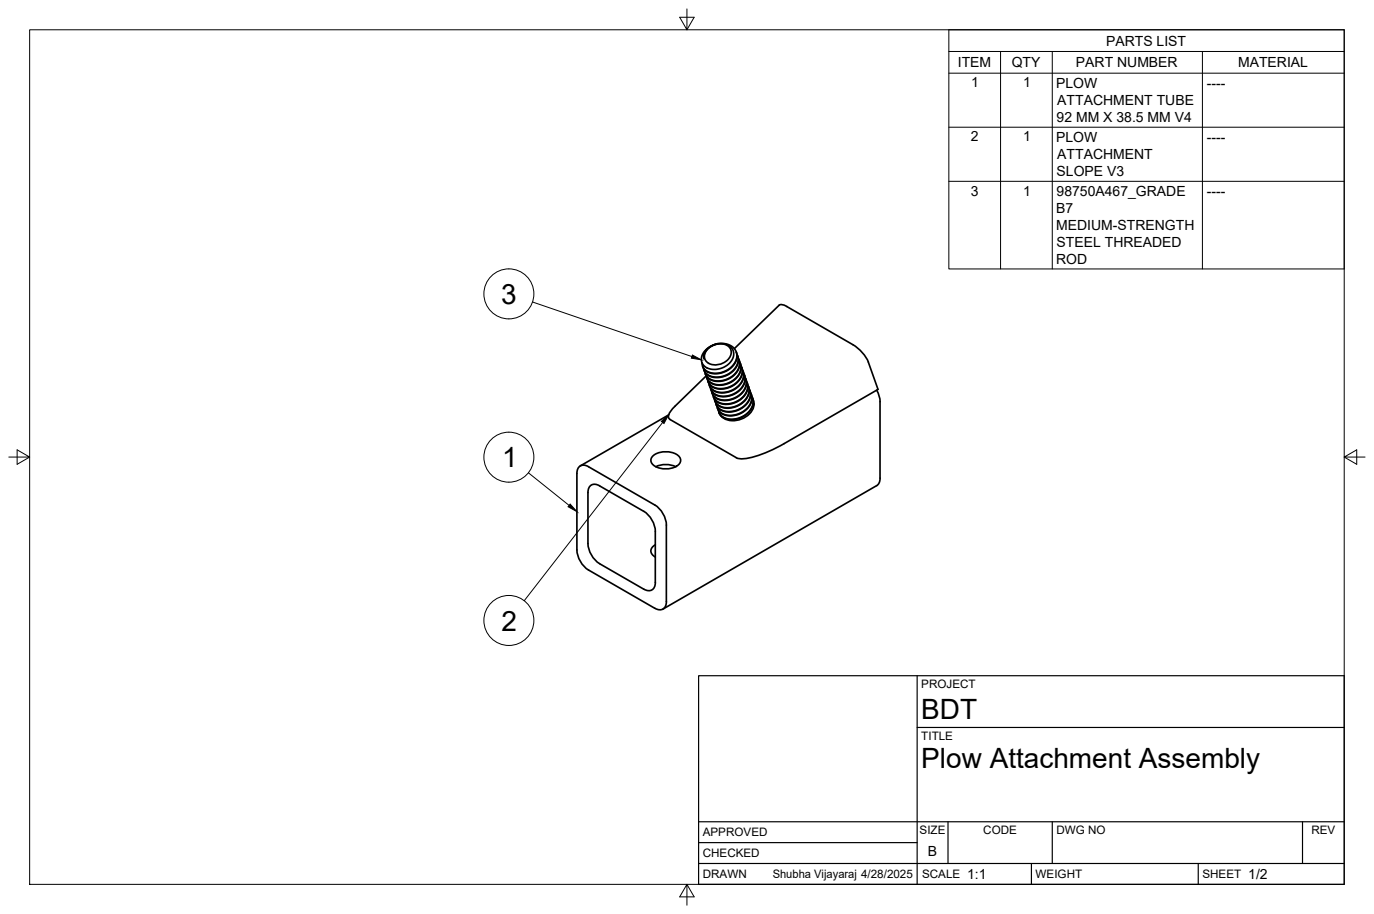
[picture p34: page 1]
SIZE; CODE; DWG NO; REV; Shubha Vijayaraj 4/28/2025; PARTS LIST

ITEM | QTY | PART NUMBER | MATERIAL
1 | 1 1 | PLOW PLOW ATTACHMENT TUBE 92 MM X 38.5 MM V4 | ---- 2

1 | 98750A467_GRADE ATTACHMENT SLOPE V3 | ---- 3

B7 MEDIUM-STRENGTH STEEL THREADED ROD | ----

PROJECT
BDT
Plow Attachment Assembly

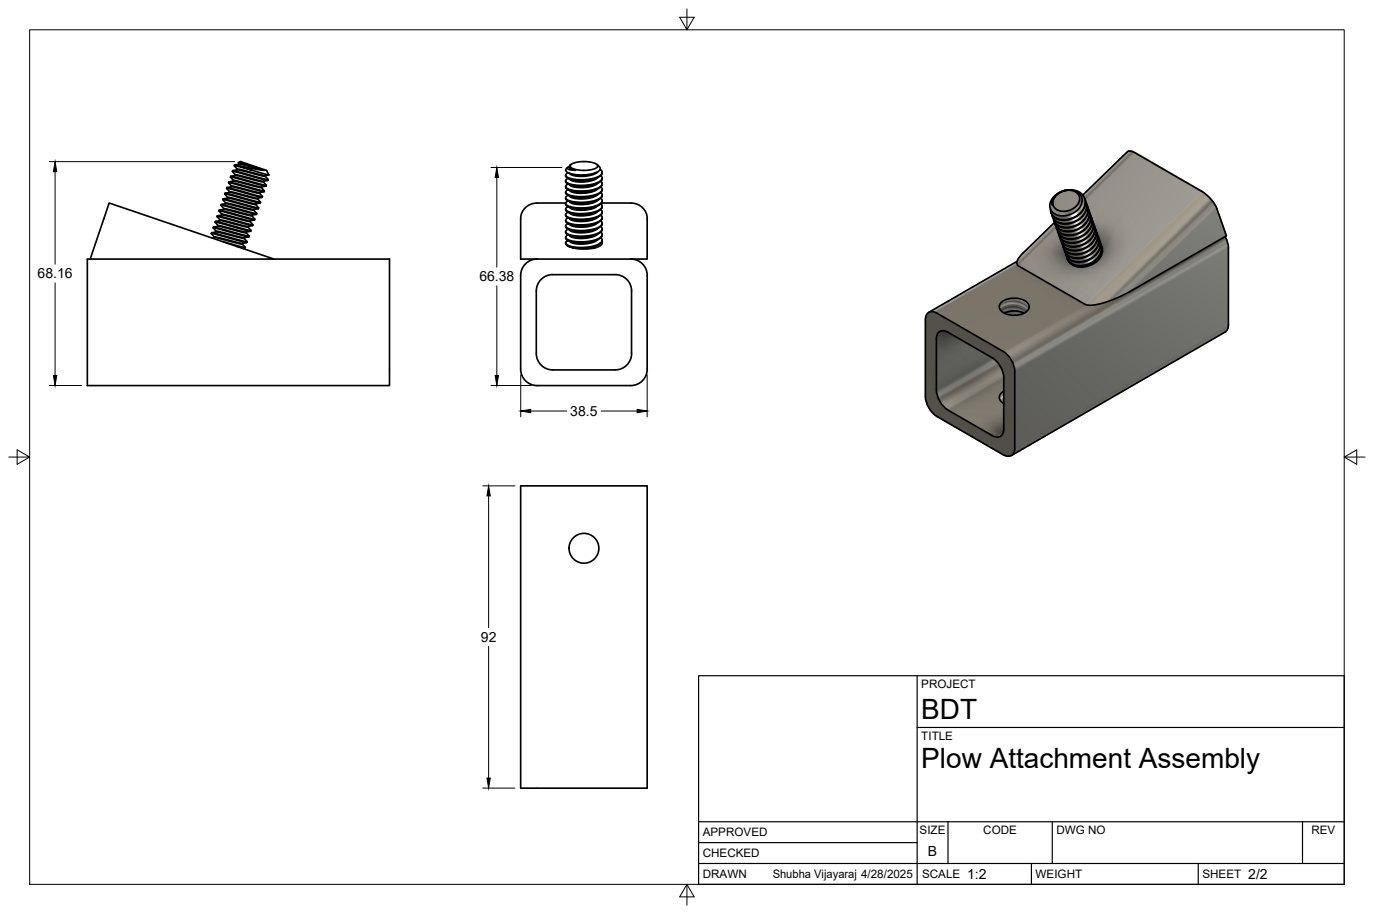
[picture p35: page 2]
SIZE; CODE; DWG NO; REV; Shubha Vijayaraj 4/28/2025

PROJECT
BDT
Plow Attachment Assembly
