ShubhaVijayaraj/EPICS-INDIA-Bullock-Driven-Tractor-Delivery/Deliverables/Drawings/Frame/90222A802_Steel Weld-Mount Retractable Spring Plunger Drawing v1.pdf

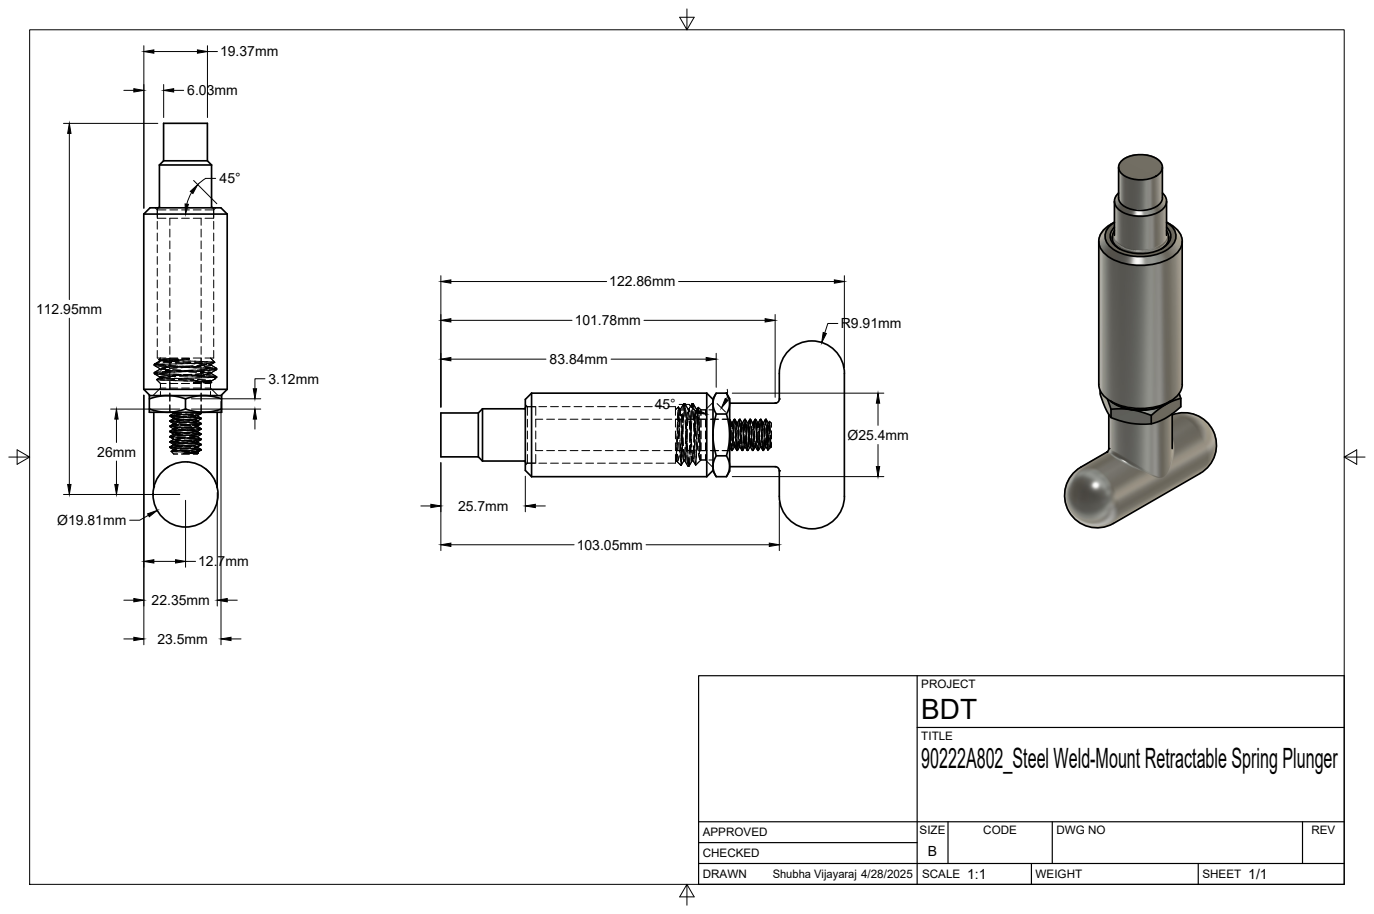
[picture p36: page 1]
SIZE; CODE; DWG NO; REV; Shubha Vijayaraj 4/28/2025

PROJECT
BDT
90222A802_Steel Weld-Mount Retractable Spring Plunger
