ShubhaVijayaraj/EPICS-INDIA-Bullock-Driven-Tractor-Delivery/Deliverables/Drawings/Frame/Final FRAME Drawing v1.pdf

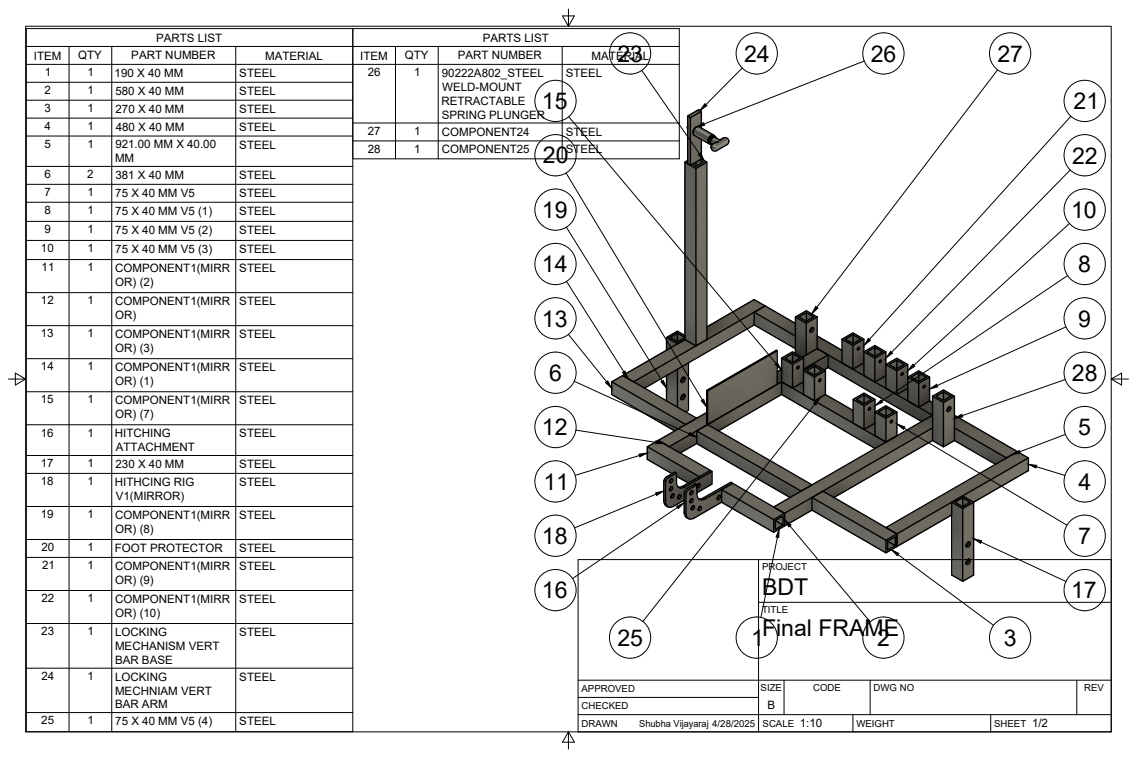
[picture p37: page 1]
Shubha Vijayaraj 4/28/2025; Final FRAME; STEEL

PARTS LIST | PARTS LIST

ITEM | QTY | PART NUMBER | MATERIAL | ITEM | QTY | PART NUMBER | MATERIAL
1 | 1 | 190 X 40 MM | STEEL | 26 | 1 | 90222A802_STEEL WELD-MOUNT 15 RETRACTABLE SPRING PLUNGER | STEEL
2 | 1 | 580 X 40 MM | STEEL
3 | 1 | 270 X 40 MM | STEEL
4 | 1 | 480 X 40 MM | STEEL
5 | 1 | 921.00 MM X 40.00 MM | STEEL

27 | 1 | COMPONENT24 | STEEL
28 | 1 | COMPONENT25 | STEEL

6 | 2 | 381 X 40 MM | STEEL
7 | 1 | 75 X 40 MM V5 | STEEL
8 | 1 | 75 X 40 MM V5 (1) | STEEL
9 | 1 | 75 X 40 MM V5 (2) | STEEL
10 | 1 | 75 X 40 MM V5 (3) | STEEL
11 | 1 | COMPONENT1(MIRR OR) (2) | STEEL

12 | 1 | COMPONENT1(MIRR OR) | STEEL

13 | 1 | COMPONENT1(MIRR OR) (3) | STEEL

14 | 1 | COMPONENT1(MIRR OR) (1) | STEEL

15 | 1 | COMPONENT1(MIRR OR) (7) | STEEL

16 | 1 | HITCHING ATTACHMENT | STEEL

17 | 1 | 230 X 40 MM | STEEL
18 | 1 | HITHCING RIG V1(MIRROR) | STEEL

19 | 1 | COMPONENT1(MIRR OR) (8) | STEEL

20 | 1 | FOOT PROTECTOR | STEEL
21 | 1 | COMPONENT1(MIRR OR) (9) | STEEL

22 | 1 | COMPONENT1(MIRR OR) (10) | STEEL

23 | 1 | LOCKING MECHANISM VERT BAR BASE | STEEL

24 | 1 | LOCKING MECHNIAM VERT BAR ARM | STEEL

APPROVED | SIZE B | CODE | DWG NO | REV

CHECKED

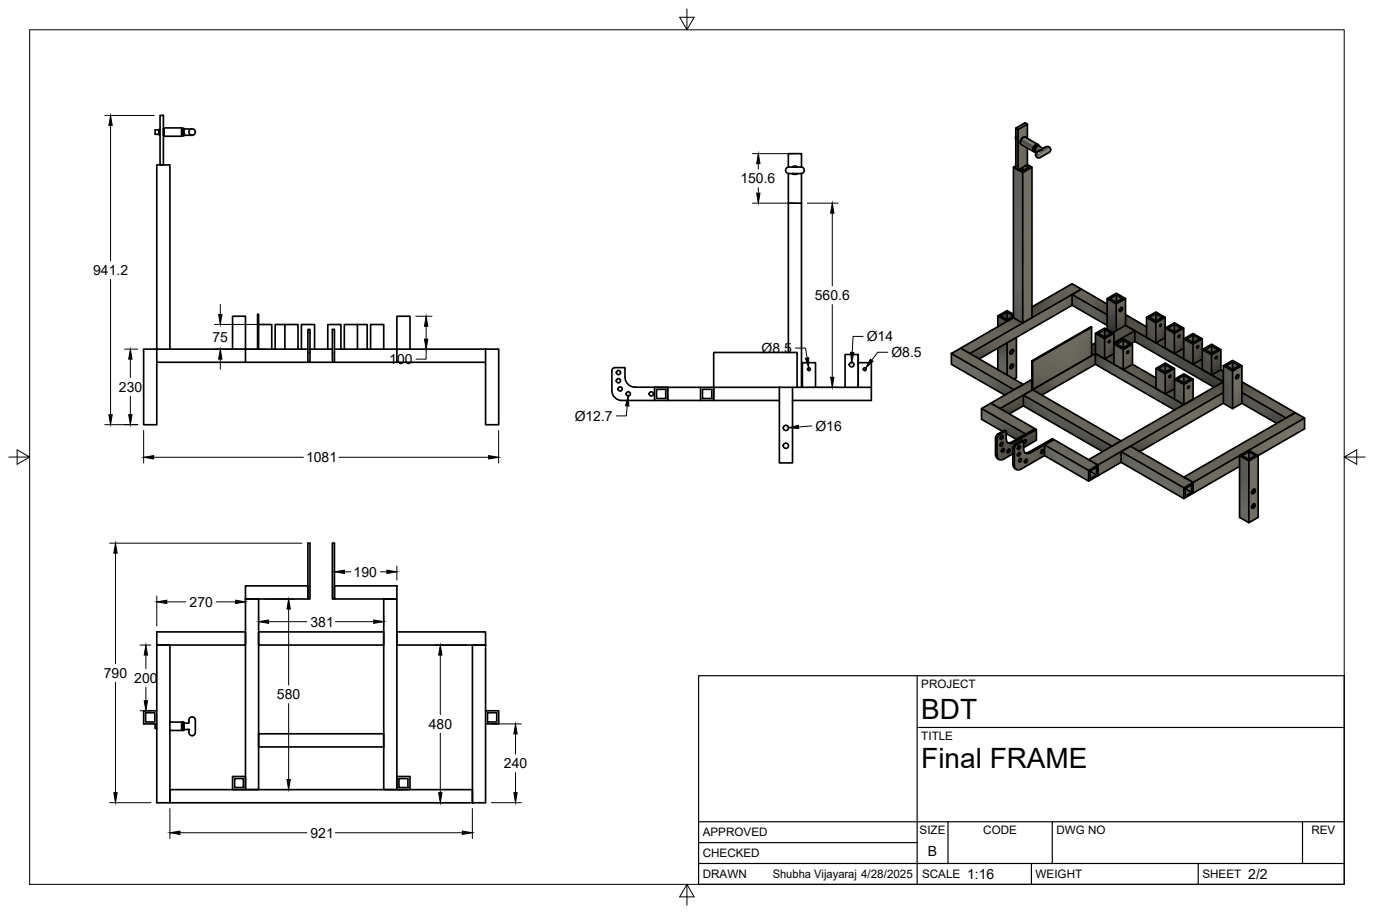
[picture p38: page 2]
SIZE; CODE; DWG NO; REV; Shubha Vijayaraj 4/28/2025; Final FRAME
