ShubhaVijayaraj/EPICS-INDIA-Bullock-Driven-Tractor-Delivery/Deliverables/Drawings/Frame/Hitching Attachment Drawing.pdf

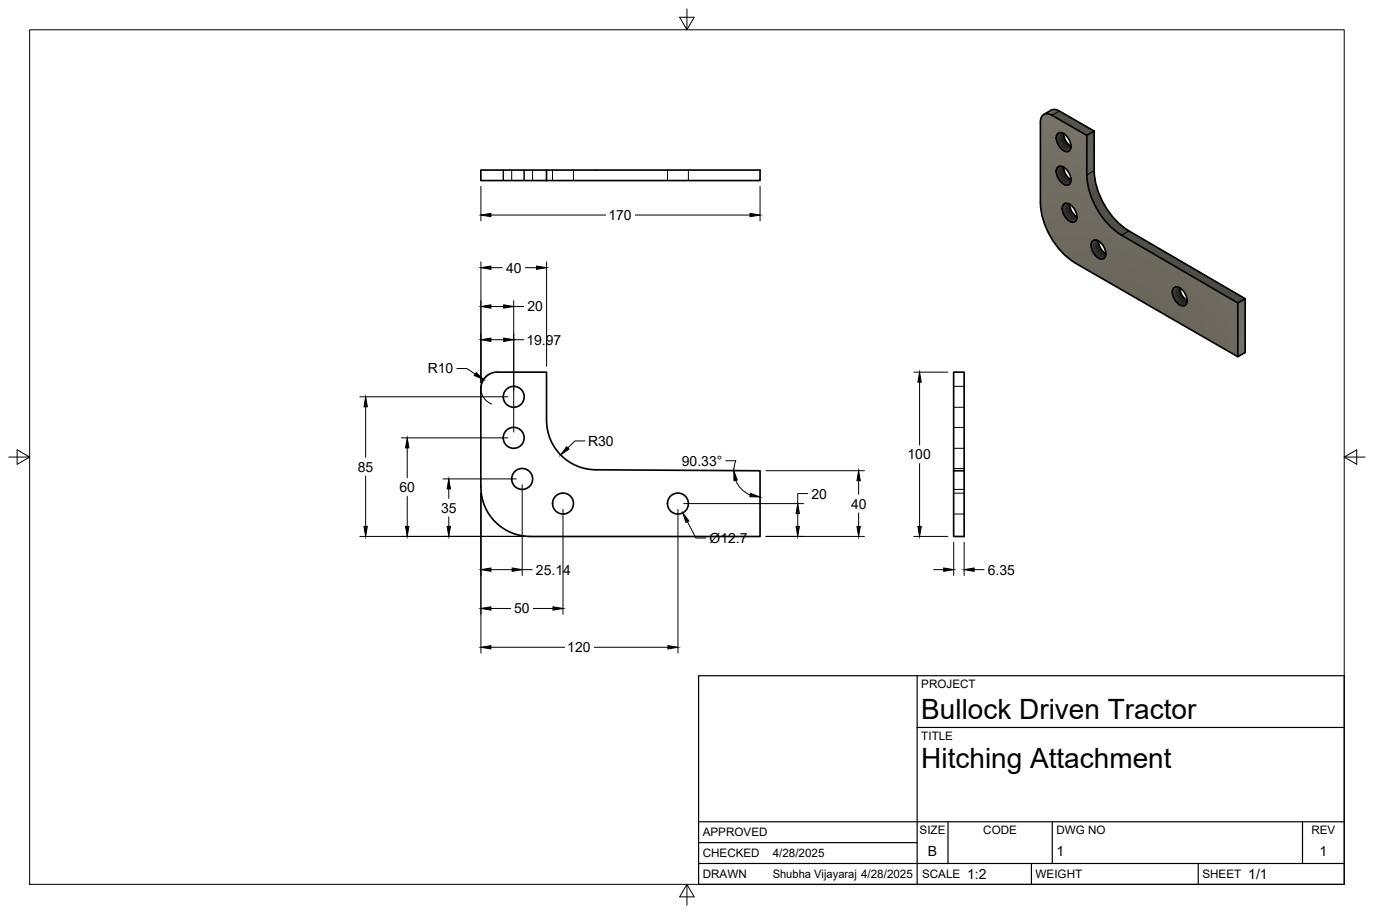
[picture p39: page 1]
SIZE; CODE; DWG NO; REV; Shubha Vijayaraj 4/28/2025

PROJECT
Bullock Driven Tractor
Hitching Attachment
