ShubhaVijayaraj/EPICS-INDIA-Bullock-Driven-Tractor-Delivery/Deliverables/Drawings/Frame/Locking Mechniam Vert Bar Arm Drawing v1.pdf

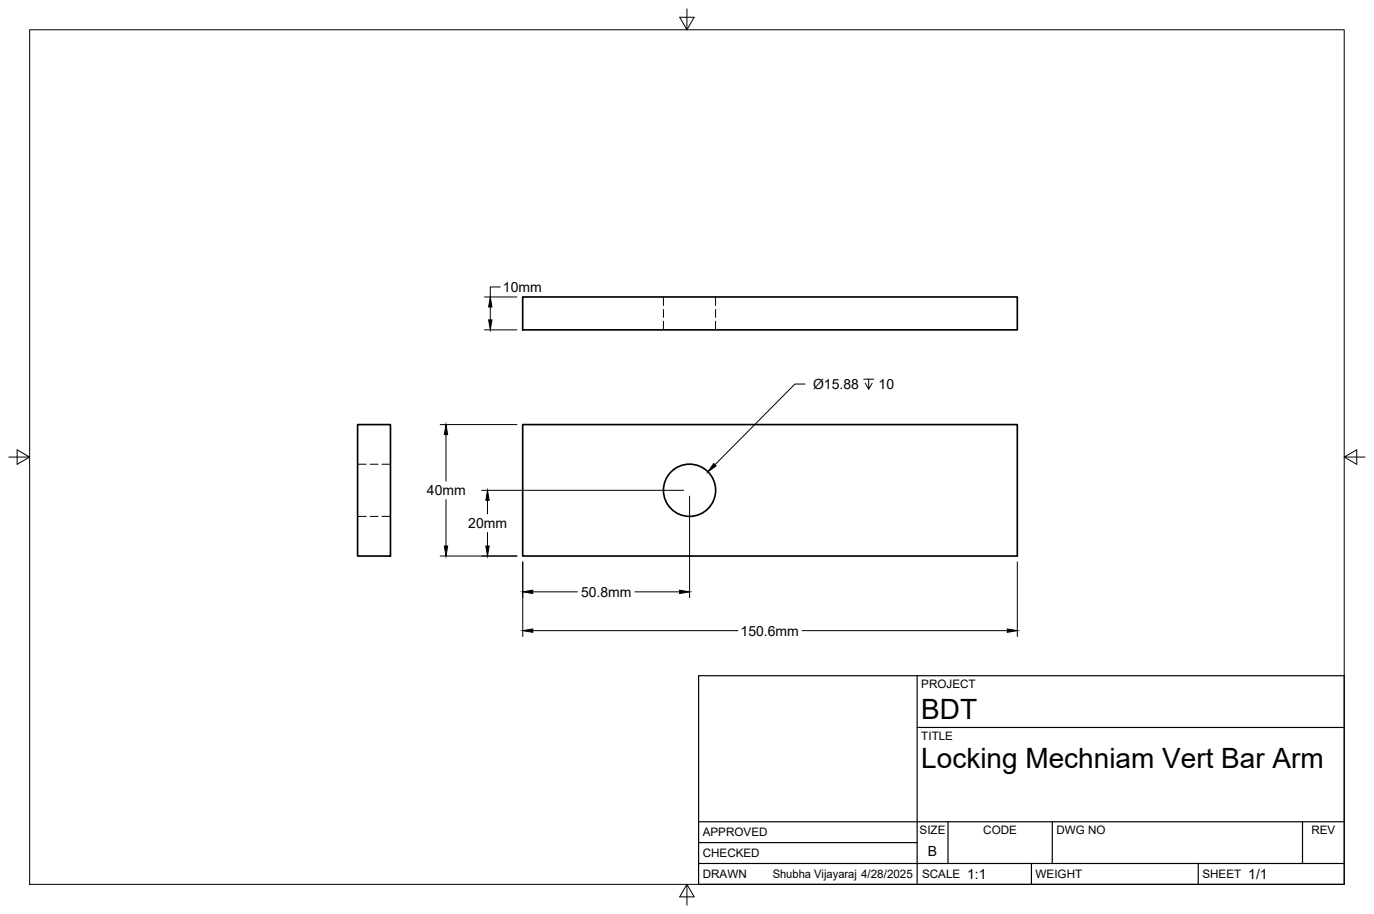
[picture p40: page 1]
SIZE; CODE; DWG NO; REV; Shubha Vijayaraj 4/28/2025

PROJECT
BDT
Locking Mechniam Vert Bar Arm
