ShubhaVijayaraj/EPICS-INDIA-Bullock-Driven-Tractor-Delivery/Deliverables/Drawings/Lifting and Locking Mechanism/Lifting Mechanism Drawing v1.pdf

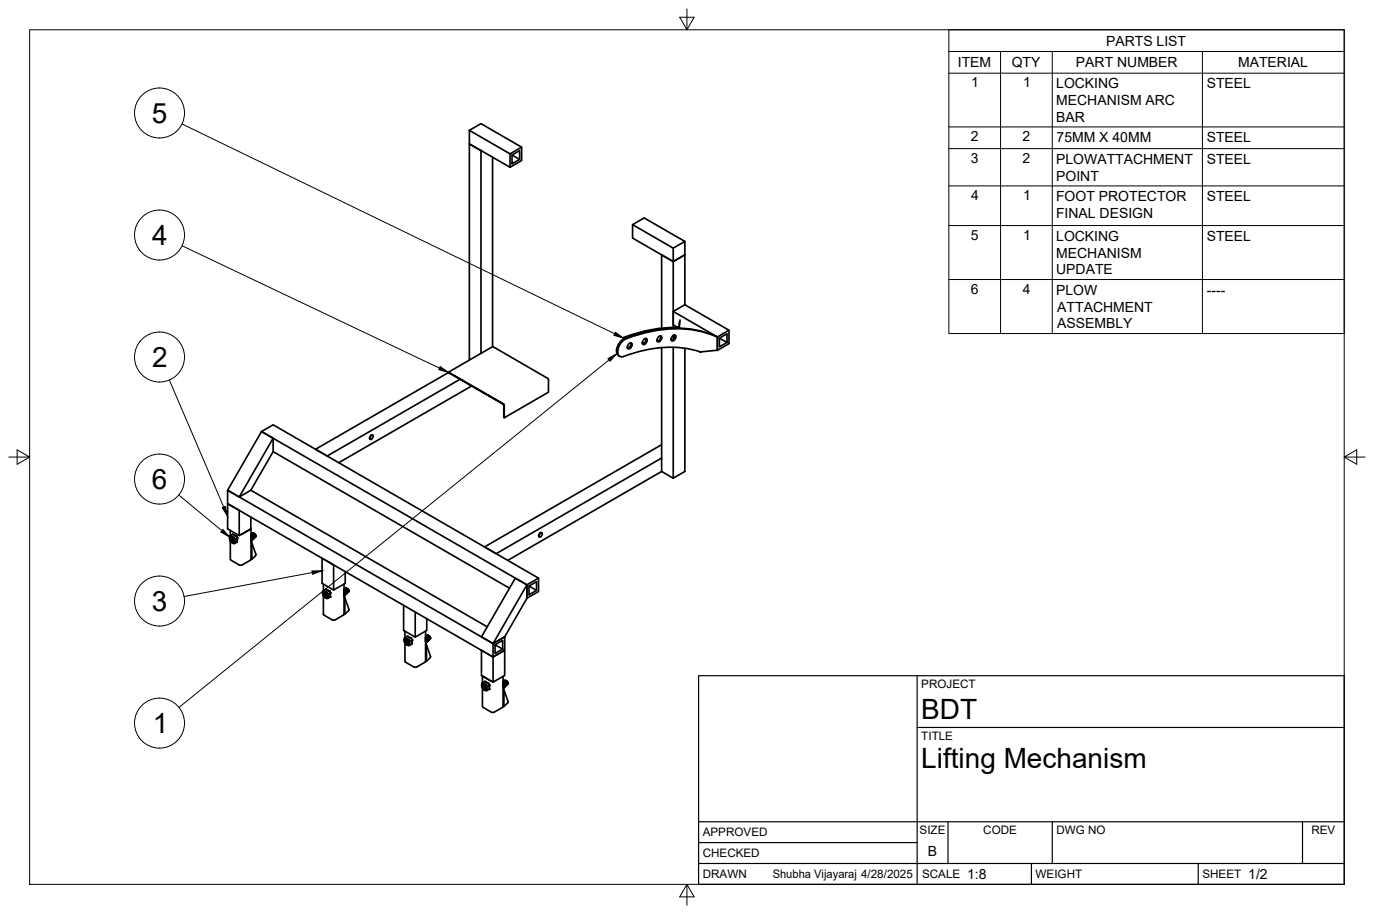
[picture p41: page 1]
SIZE; CODE; DWG NO; REV; Shubha Vijayaraj 4/28/2025; Lifting Mechanism; PARTS LIST

ITEM | QTY | PART NUMBER | MATERIAL
1 | 1 | LOCKING MECHANISM ARC BAR | STEEL

2 | 2 | 75MM X 40MM | STEEL
3 | 2 | PLOWATTACHMENT POINT | STEEL

4 | 1 | FOOT PROTECTOR FINAL DESIGN | STEEL

5 | 1 | LOCKING MECHANISM UPDATE | STEEL

6 | 4 | PLOW ATTACHMENT ASSEMBLY | ----

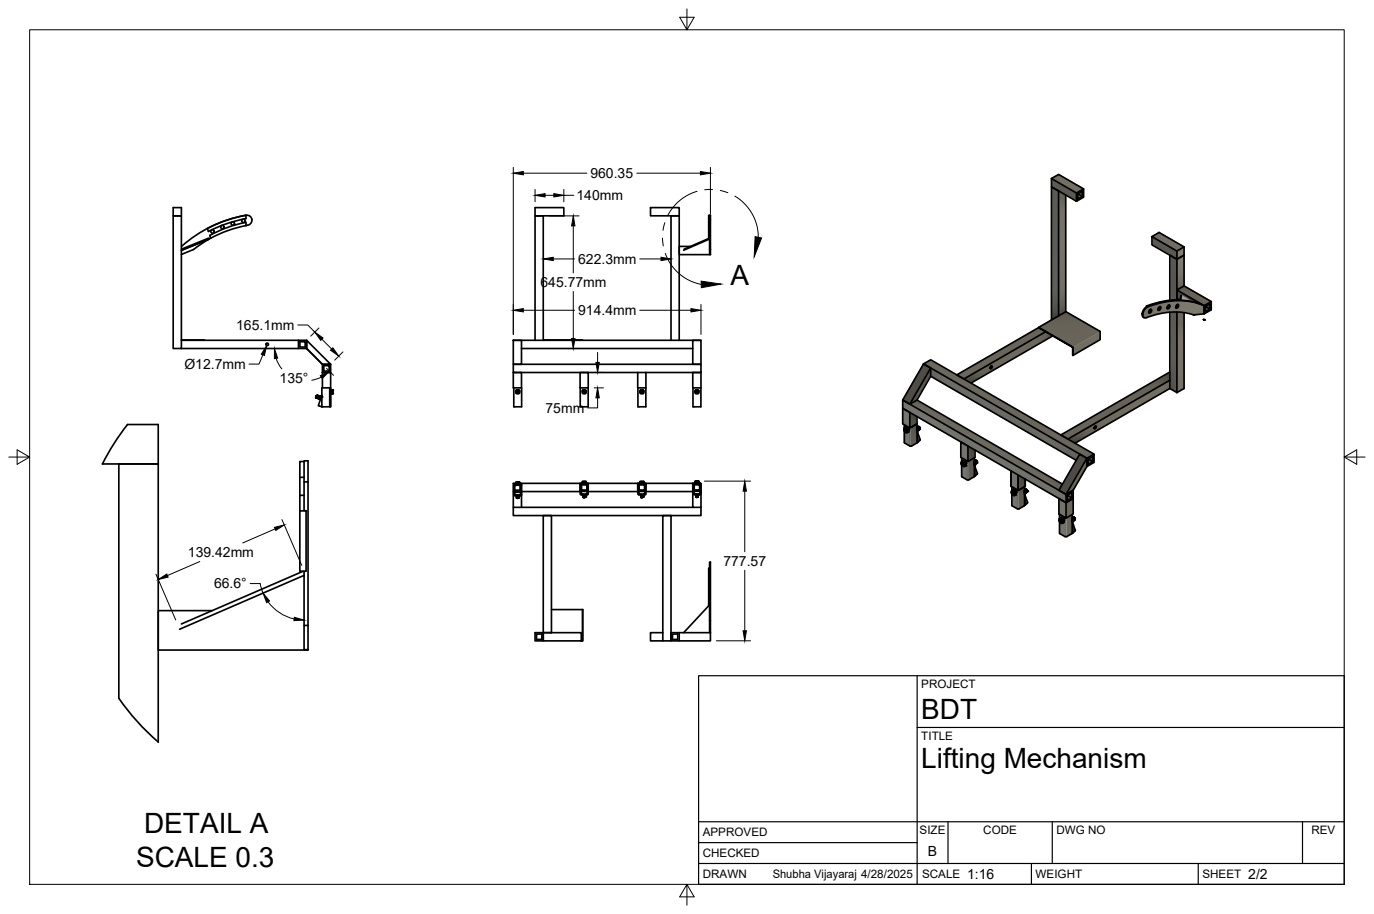
[picture p42: page 2]
SIZE; CODE; DWG NO; REV; Shubha Vijayaraj 4/28/2025; Lifting Mechanism; DETAIL A SCALE 0.3
