ShubhaVijayaraj/EPICS-INDIA-Bullock-Driven-Tractor-Delivery/Deliverables/Drawings/Lifting and Locking Mechanism/Locking Mechanism Arc Bar Drawing v1.pdf

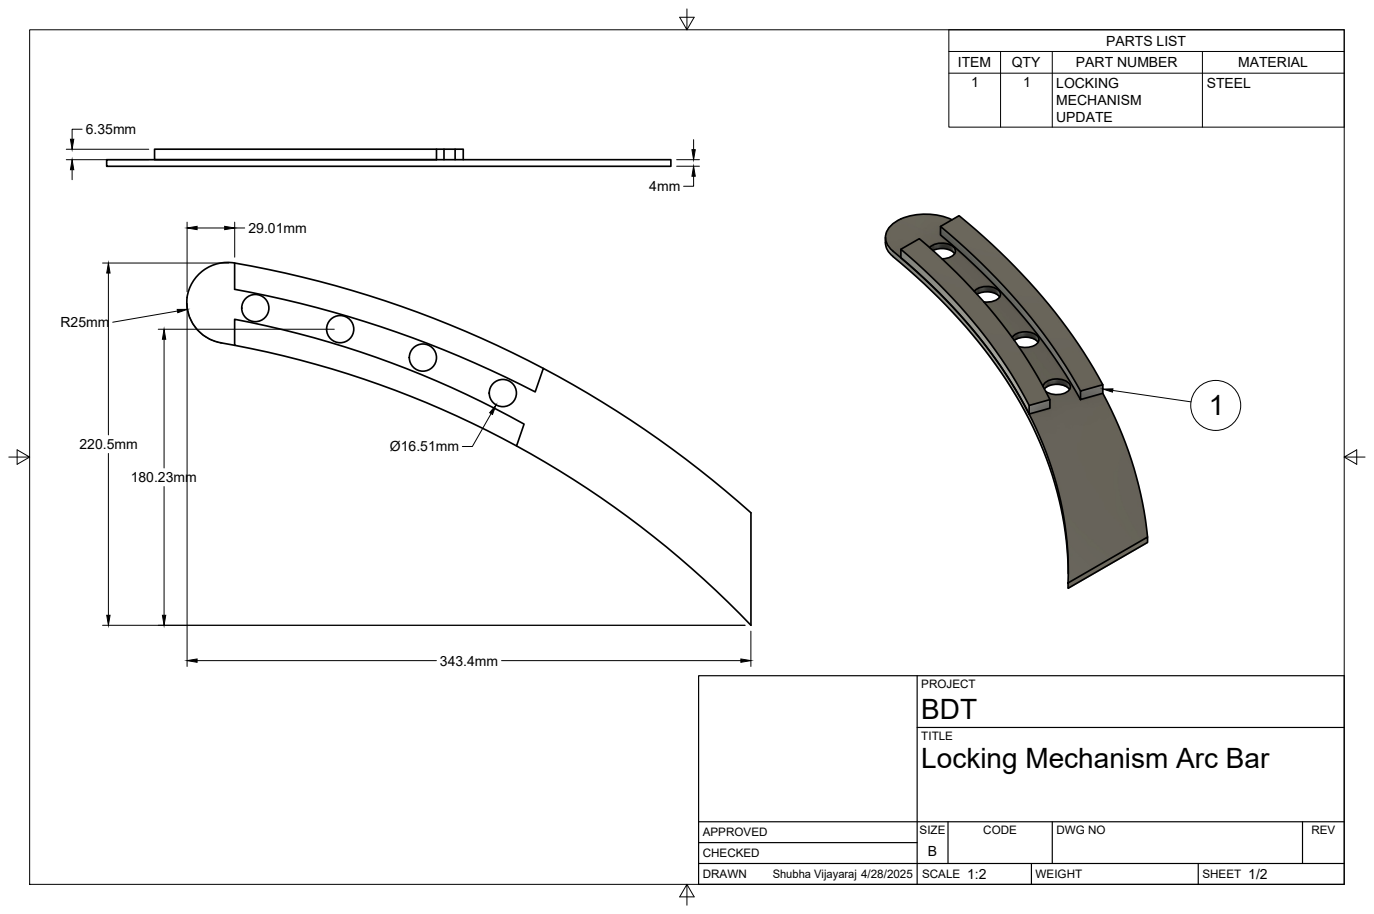
[picture p43: page 1]
SIZE; CODE; DWG NO; REV; Shubha Vijayaraj 4/28/2025; PARTS LIST

ITEM | QTY | PART NUMBER | MATERIAL
1 | 1 | LOCKING MECHANISM UPDATE | STEEL

PROJECT
BDT
Locking Mechanism Arc Bar

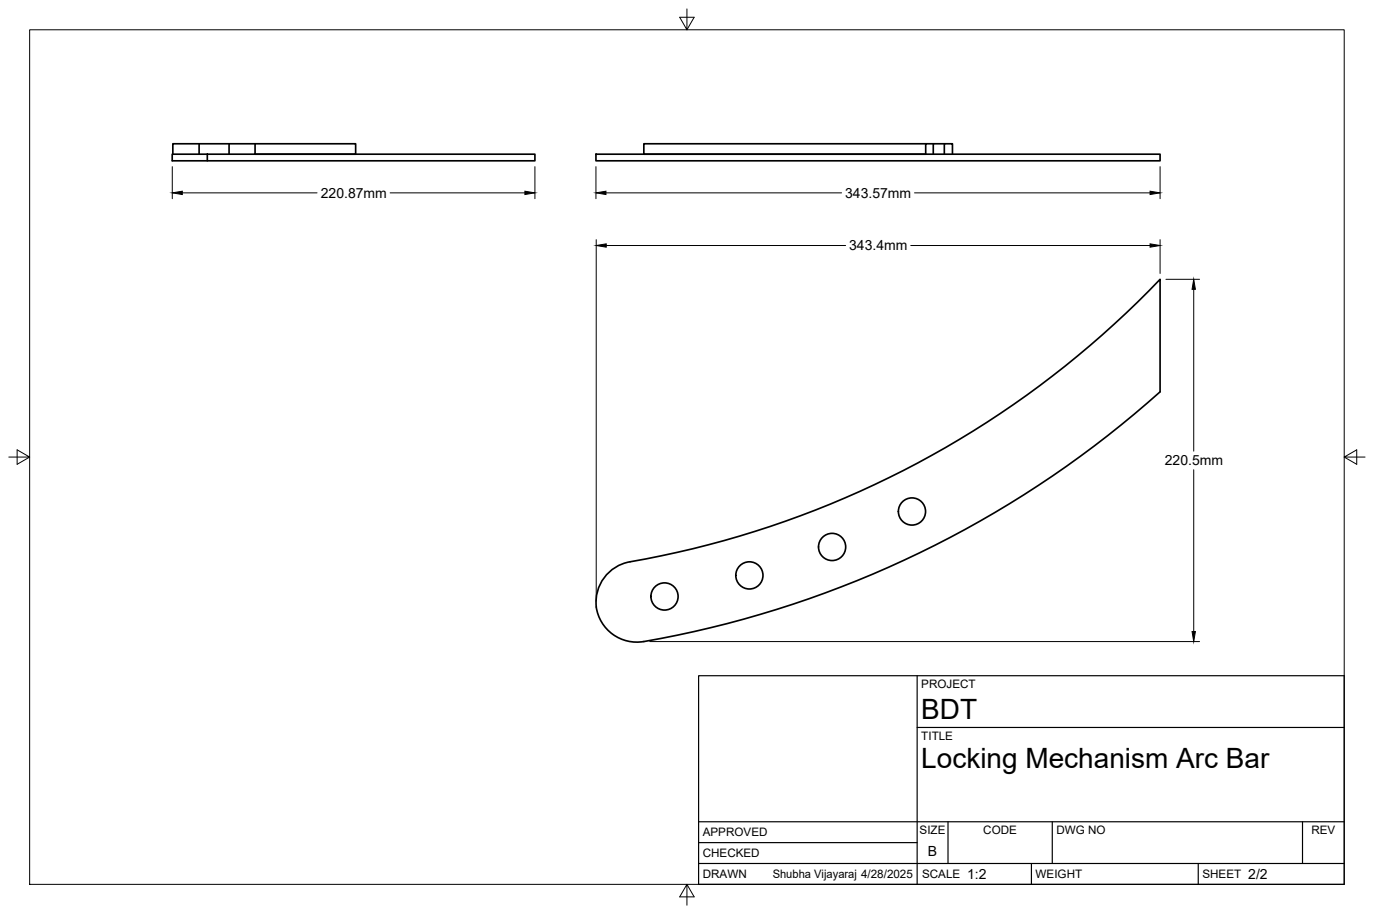
[picture p44: page 2]
SIZE; CODE; DWG NO; REV; Shubha Vijayaraj 4/28/2025

PROJECT
BDT
Locking Mechanism Arc Bar
