ShubhaVijayaraj/EPICS-INDIA-Bullock-Driven-Tractor-Delivery/Deliverables/Drawings/Lifting and Locking Mechanism/Plow Attachment Tube Drawing v4.pdf

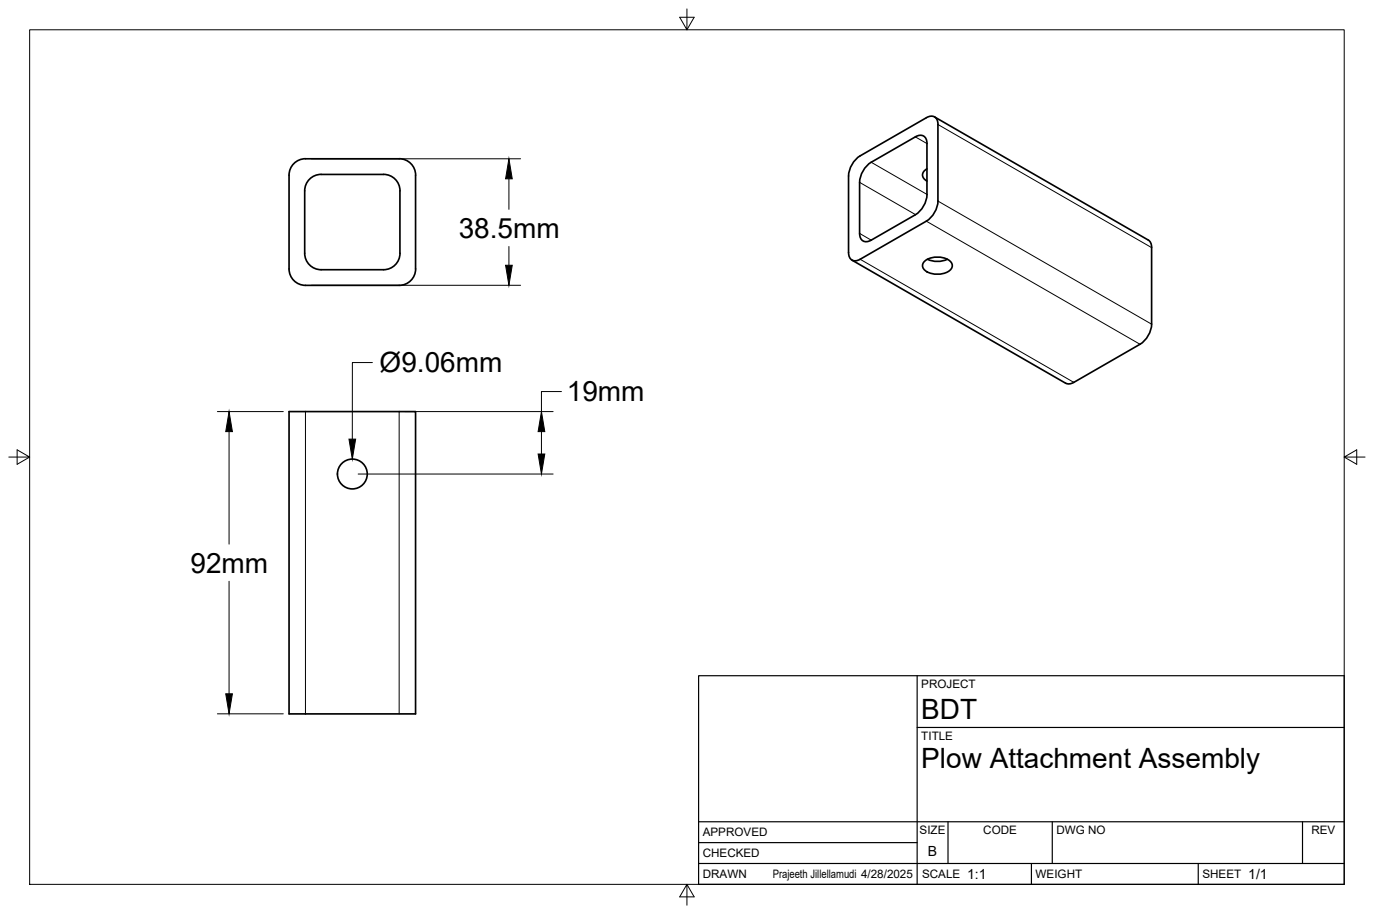
[picture p46: page 1]
SIZE; CODE; DWG NO; REV; Prajeeth Jillellamudi 4/28/2025

PROJECT
BDT
Plow Attachment Assembly
