ShubhaVijayaraj/EPICS-INDIA-Bullock-Driven-Tractor-Delivery/Deliverables/Drawings/Seat/Pressure Bars Drawing v1.pdf

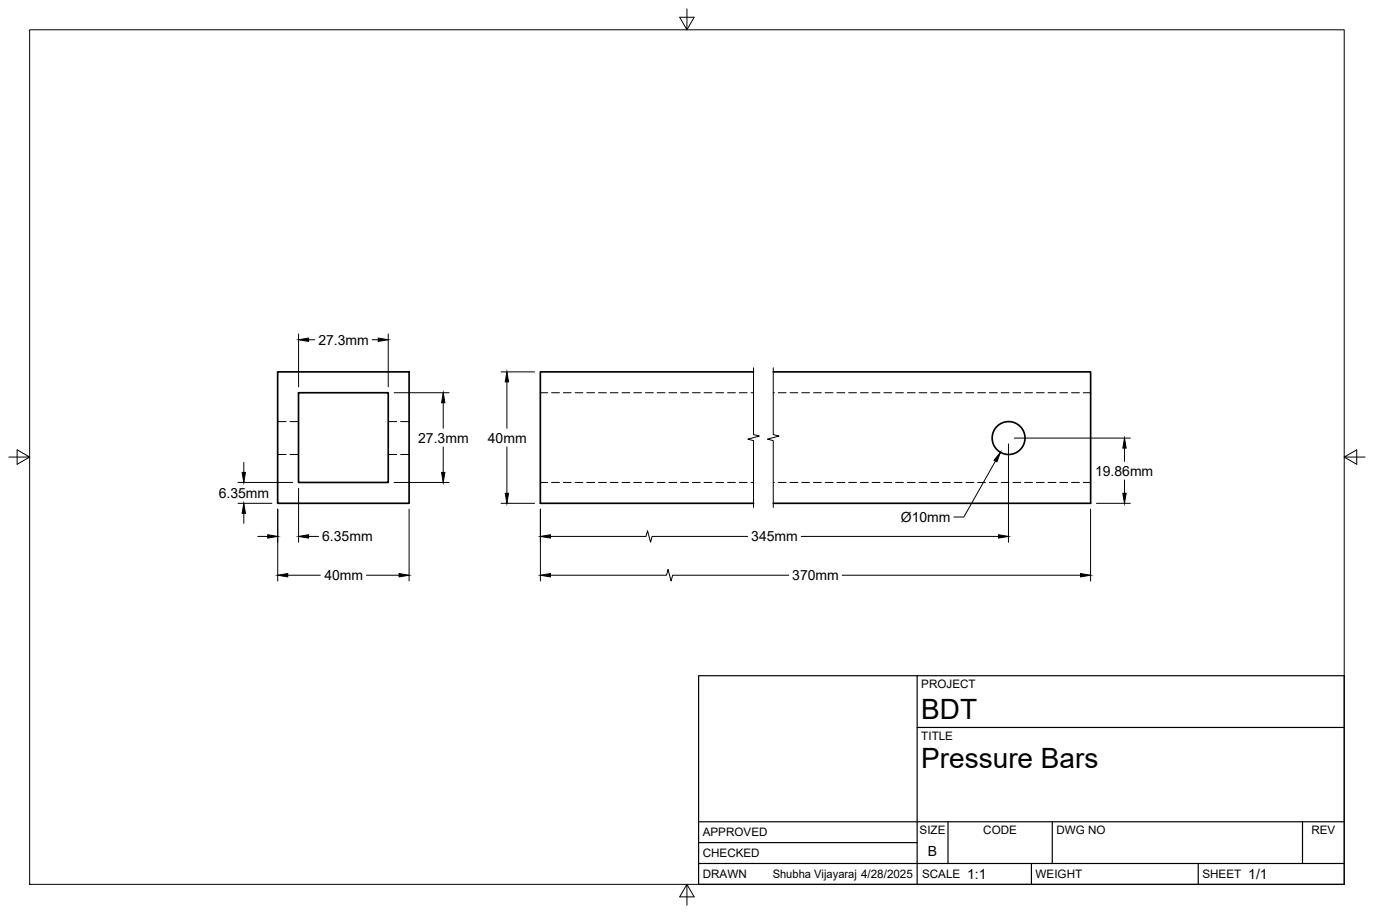
[picture p47: page 1]
SIZE; CODE; DWG NO; REV; Shubha Vijayaraj 4/28/2025; Pressure Bars
