ShubhaVijayaraj/EPICS-INDIA-Bullock-Driven-Tractor-Delivery/Deliverables/Drawings/Lifting and Locking Mechanism/Arc Bar Guides.pdf

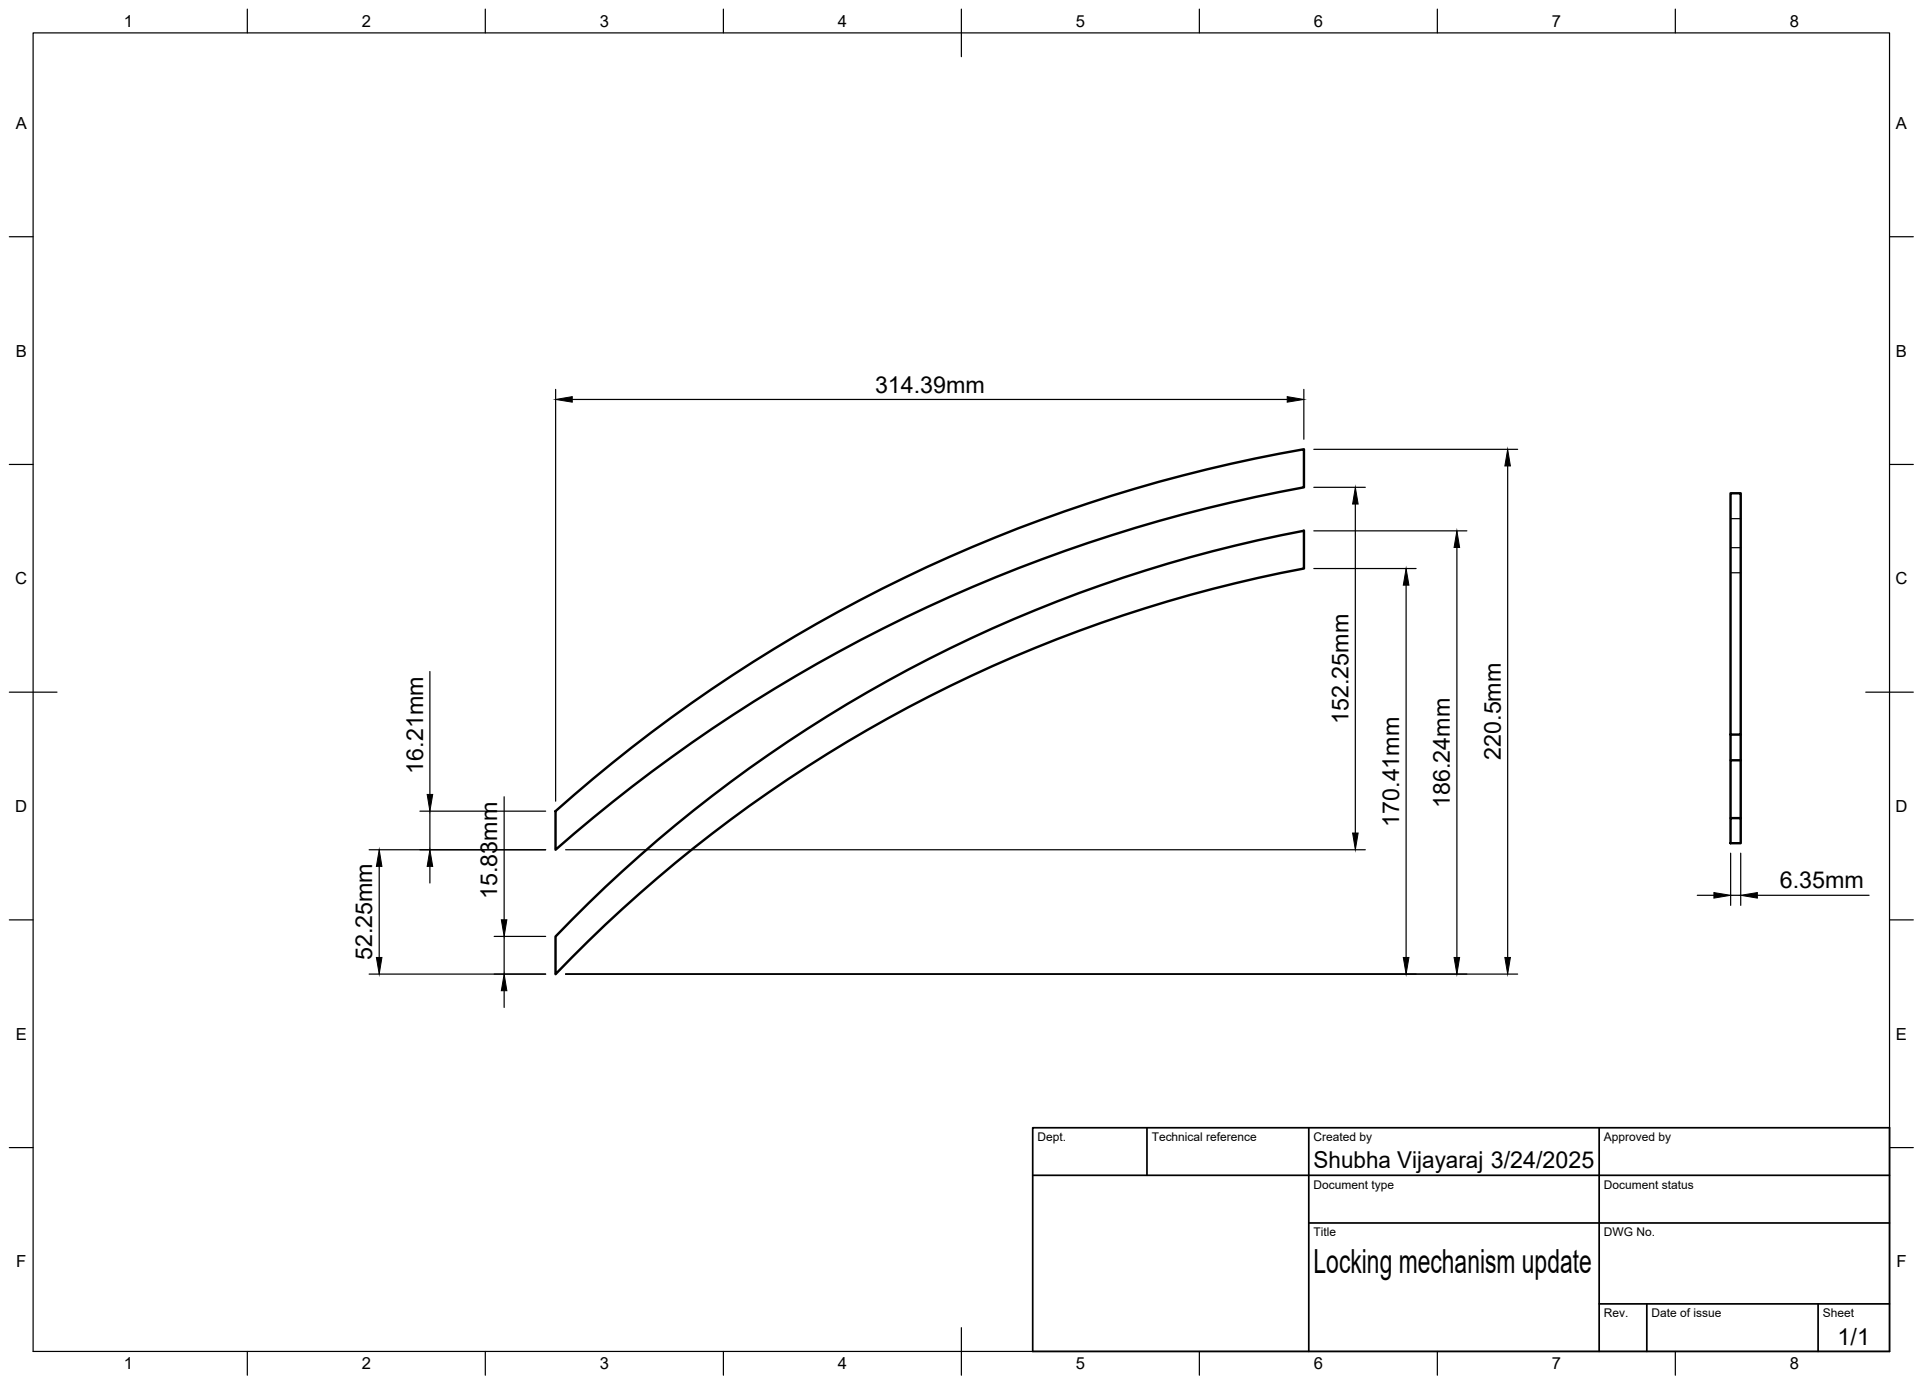
[picture p48: page 1]
Title; DWG No.; Rev.; Date of issue; Sheet

Dept. | Technical reference | Created by Shubha Vijayaraj 3/24/2025 | Approved by

Document type | Document status

Locking mechanism update
