ShubhaVijayaraj/EPICS-INDIA-Bullock-Driven-Tractor-Delivery/Deliverables/Drawings/Hitching Bar Drawing v1.pdf

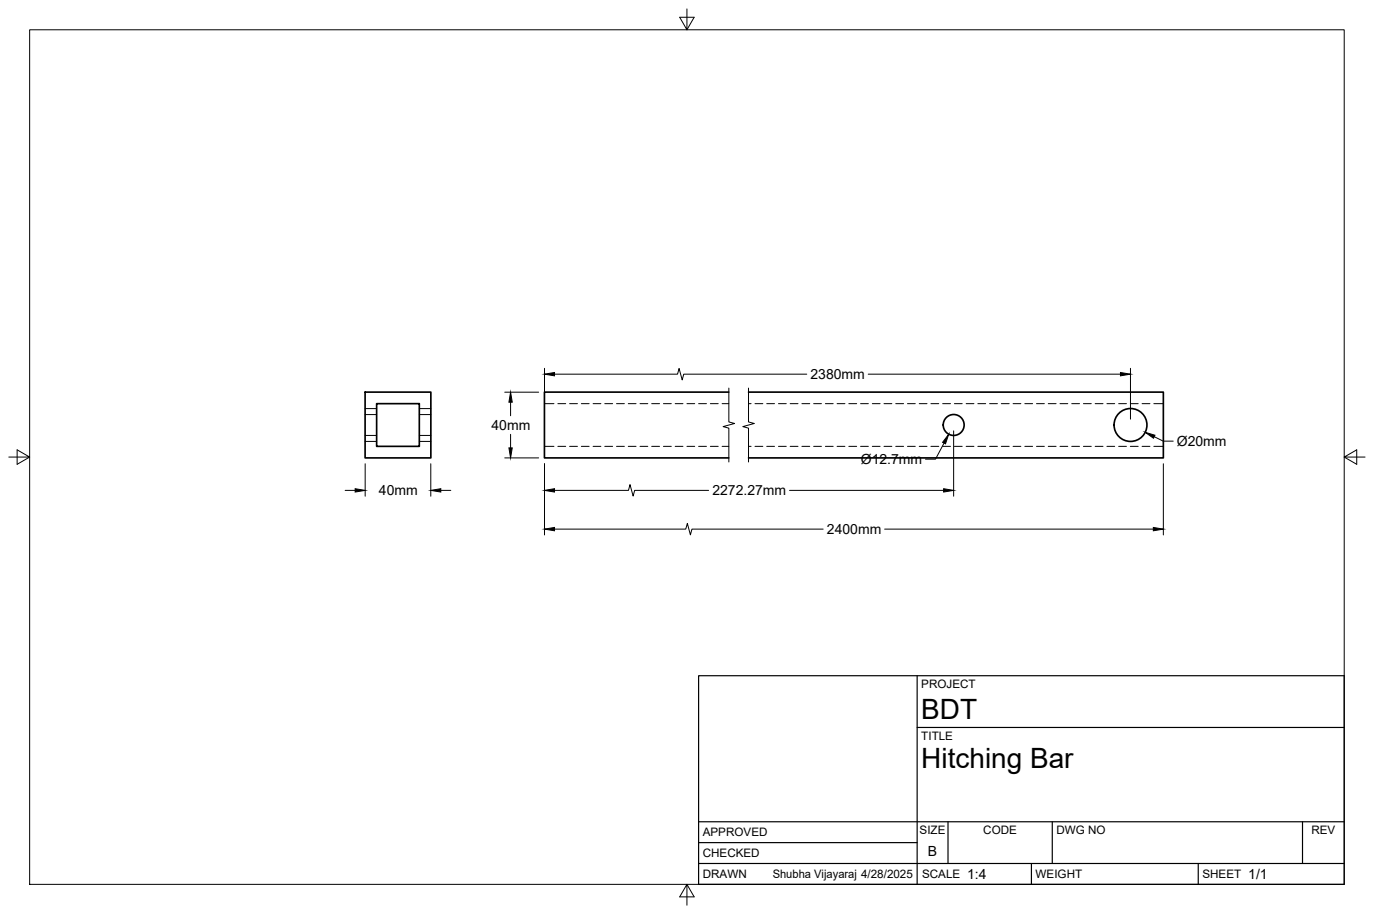
[picture p50: page 1]
SIZE; CODE; DWG NO; REV; Shubha Vijayaraj 4/28/2025; Hitching Bar
