ShubhaVijayaraj/EPICS-INDIA-Bullock-Driven-Tractor-Delivery/Deliverables/Drawings/Frame/Frame Foot Protector Drawing.pdf

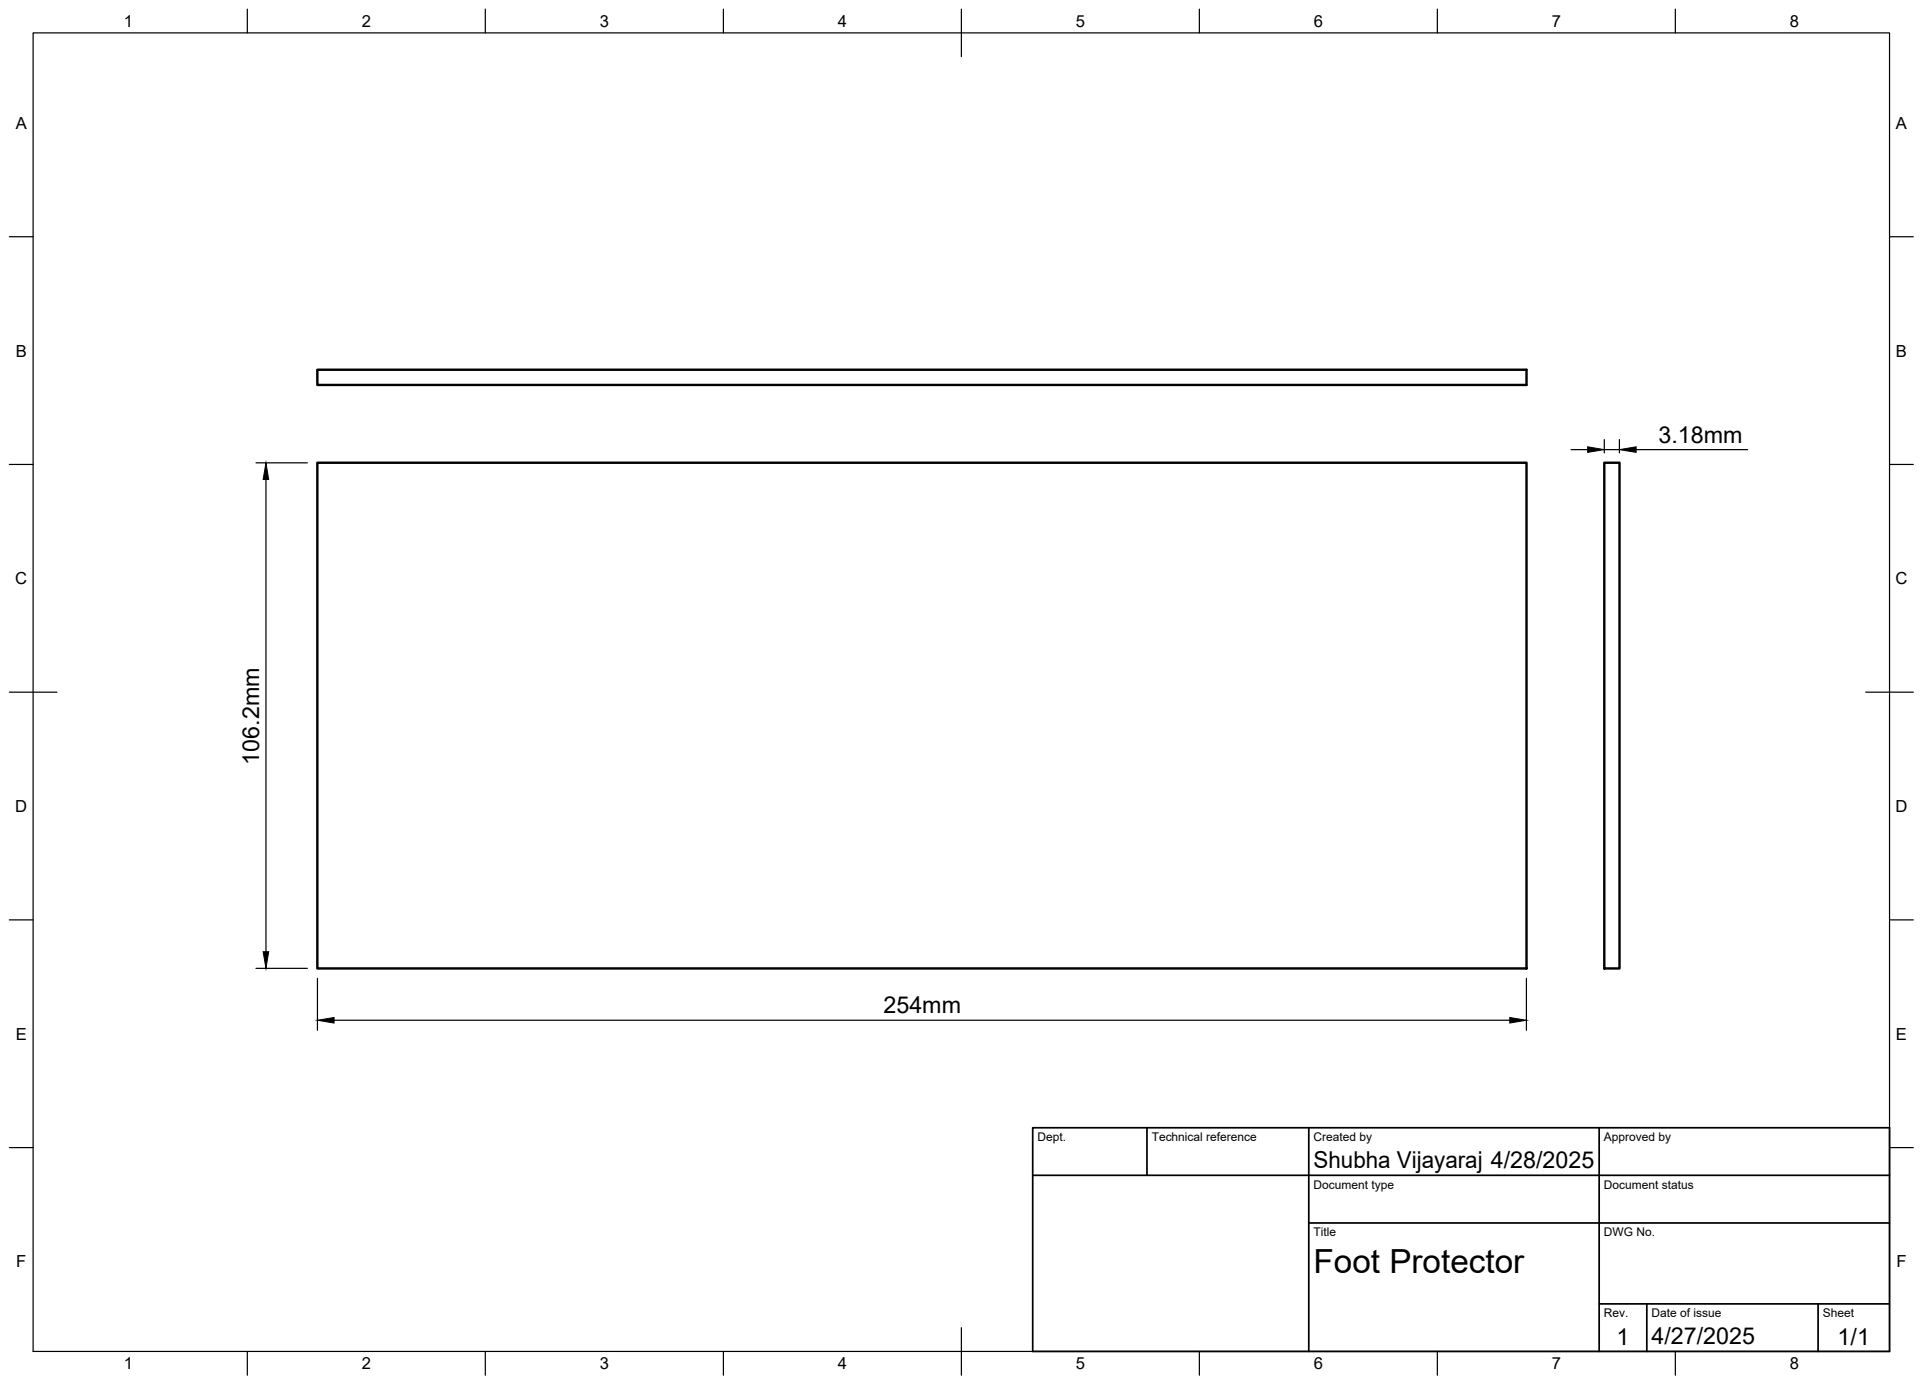
[picture p51: page 1]
Title; DWG No.; Rev.; Date of issue; Sheet; Foot Protector

Dept. | Technical reference | Created by Shubha Vijayaraj 4/28/2025 | Approved by

Document type | Document status
