ShubhaVijayaraj/EPICS-INDIA-Bullock-Driven-Tractor-Delivery/Deliverables/Drawings/Seat/Chair Stand Drawing v1.pdf

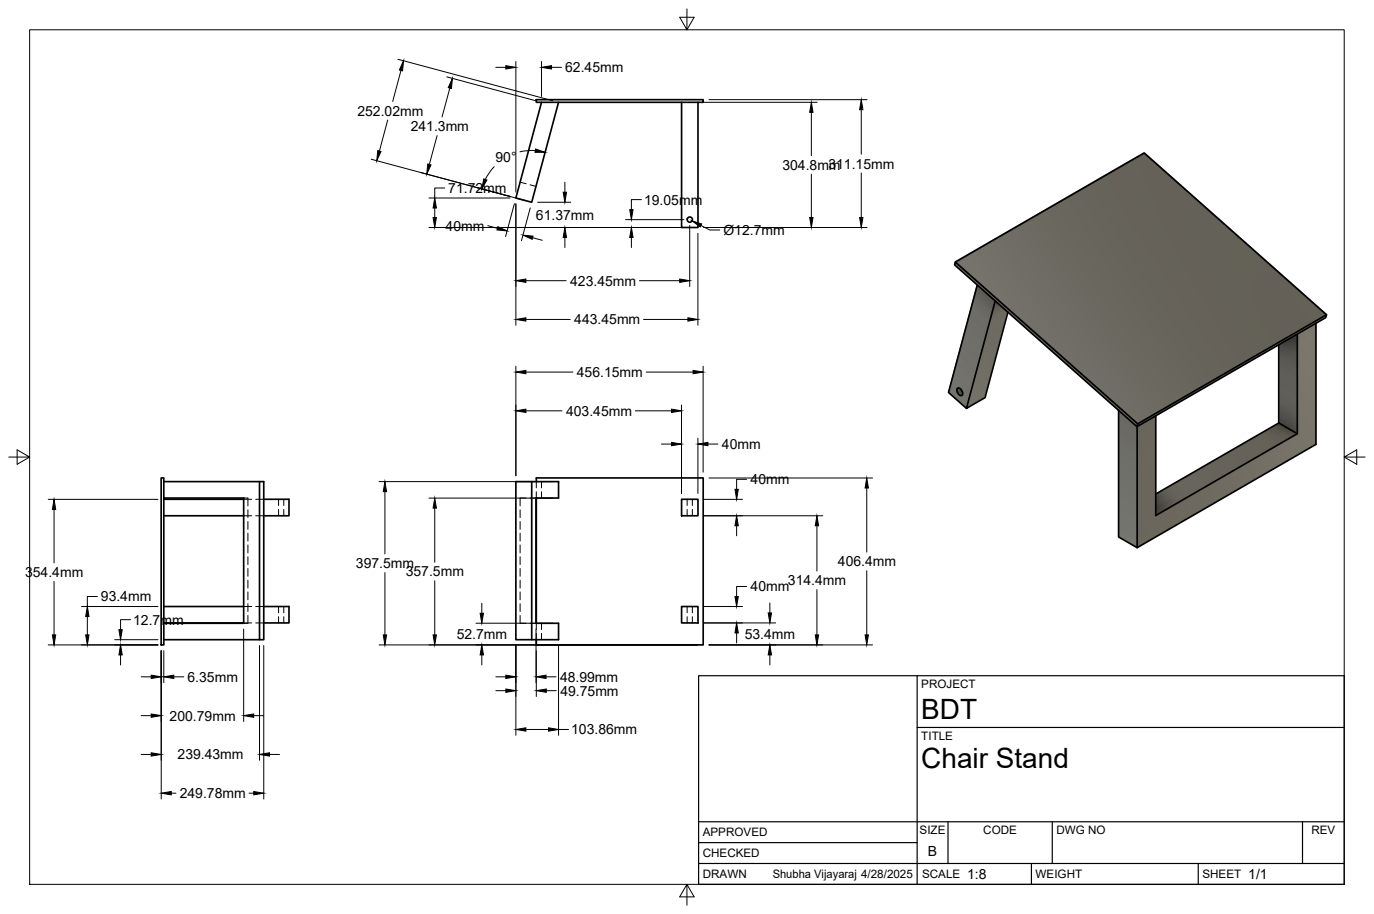
[picture p52: page 1]
SIZE; CODE; DWG NO; REV; Shubha Vijayaraj 4/28/2025; Chair Stand
